iThinkiKhan/Universal-Robotics-Remote/exports/README.md

# Derived exports

Generated STEP models, drawings and review images belong here, with source revision and validation evidence. Native designs remain under cad/ and electronics/. Toolchain smoke exports are synthetic fixtures, not controller models or print deliveries. No automatic slicing or printer upload occurs.
