iThinkiKhan/Universal-Robotics-Remote/reference/README.md

# Reference material

Store upstream manuals, datasheets and externally supplied geometry with source URL, revision and license/provenance. Hardware photographs currently live in measurements/photos/. Do not promote a reference dimension to a measured assembly fact without evidence.
