iThinkiKhan/Universal-Robotics-Remote/THIRD_PARTY.md

# Third-party provenance

The synthetic ECAD/MCAD fixture incorporates the KiCad Packages3D model `Connector_PinHeader_2.54mm.3dshapes/PinHeader_1x04_P2.54mm_Vertical.step` in derived STEP and FreeCAD review files. Source: https://gitlab.com/kicad/libraries/kicad-packages3D . Original model SHA-256: `a74079b8d06bda78847623b39ee1855ffd1d9a8c1e896b349e4f1dc2056d44d9`. The upstream KiCad library is licensed under CC BY-SA 4.0 with its electronic-design exception; see https://www.kicad.org/libraries/license/ and the upstream model headers. These fixture files are synthetic validation geometry, not the measured gamepad.

Firmware library dependencies remain pinned in firmware/platformio.ini and retain their upstream licenses. Adapted pre-existing project drivers are identified in firmware/PROVENANCE.md. No new project-wide license is selected by this publication.
