iThinkiKhan/Universal-Robotics-Remote/docs/RECOVERY.md

# Private device recovery

Exact full-flash recovery was verified before bench firmware replacement. Recovery images can contain credentials, NVS and calibration and must remain private, outside this repository and its issues/artifacts. Keep identity, checksum and restore records in the owner's private lab records. Never erase flash, replace firmware, modify eFuses or change security settings merely to review the public project. A build does not authorize upload.
