iThinkiKhan/Universal-Robotics-Remote/docs/REFERENCES.md

# References and provenance

- Owner-provided hardware photographs and measurements, recorded2026-11-10. Exact private chat identifiers and device identities are excluded.
- Reused display/touch drivers: see `firmware/PROVENANCE.md`.
- KiCad: https://www.kicad.org/ and https://docs.kicad.org/10.0/en/cli/cli.html
- FreeCAD StepUp: https://github.com/easyw/kicadStepUpMod
- WireViz: https://github.com/wireviz/WireViz
- KiCad reference geometry: see `THIRD_PARTY.md`.
