iThinkiKhan/Universal-Robotics-Remote/electronics/harness-sources-proposed.csv

harness | pin | signal | function | source_pads | pad_label | x_mm | y_mm | pad_confidence | status | gate | s3_destination | notes
J1L | 1 | L-X | Left stick X (analog) | TP31 | L-X | 108.30 | 13.40 | high | plan-ready | LX-01 G1-G3 | GPIO5 (ADC1), proposed in the registry | Free round test pad, 1.3 mm. Owner-reported 0 to 3 V with the centre near 1.5 V. Electrical connection stays gated by the LX-01 steps and a qualified protective interface. Label read from photos 3086 and 3089 on 2026-11-11; this replaces the earlier blocked row.
J1L | 2 | L-Y | Left stick Y (analog) | TP32 | L-Y | 111.10 | 13.40 | high | plan-ready | LX-01 G1-G3 | GPIO6 (ADC1), proposed in the registry | Free round test pad, 1.3 mm. Owner-reported 0 to 3 V with the centre near 1.5 V. Electrical connection stays gated by the LX-01 steps and a qualified protective interface. Label read from photos 3086 and 3089 on 2026-11-11.
J1L | 3 | L-3 | Left stick click | TP30 | L-3 | 105.60 | 13.40 | high | plan-ready | LX-01 G1-G3 | GPIO not assigned in the registry yet | Free round test pad. Active-low: about 3 V released, 0 V pressed (owner-reported 2026-11-10, electrical.csv BTN05 and BTN06). Label read from photos 3086 and 3089 on 2026-11-11.
J1L | 4 | GND (J1L) | Signal reference for J1L | TP03 | VSS | 92.45 | 34.15 | high | plan-ready |  | S3 GND | Large VSS pad (2.8 mm) beside the left-hand pads. Owner-reported 2026-11-11: VSS is ground, checked against the large GND pad TP01 (electrical.csv GND01). Shared with the other left-hand connectors' ground returns: four wires on this pad.
J1R | 1 | R-X | Right stick X (analog) | TP11 | R-X | 27.85 | 10.75 | high | plan-ready | LX-01 G1-G3 | GPIO7 (ADC1), proposed in the registry | Free round test pad, 1.2 mm. Owner-reported 0 to 3 V with the centre near 1.5 V. Electrical connection stays gated by the LX-01 steps and a qualified protective interface.
J1R | 2 | R-Y | Right stick Y (analog) | TP10 | R-Y | 27.85 | 13.55 | high | plan-ready | LX-01 G1-G3 | GPIO2 (ADC1), proposed in the registry | Free round test pad, 1.2 mm. Owner-reported 0 to 3 V with the centre near 1.5 V. Electrical connection stays gated by the LX-01 steps and a qualified protective interface.
J1R | 3 | R-3 | Right stick click | TP12 | R-3 | 24.85 | 9.85 | high | plan-ready | LX-01 G1-G3 | GPIO not assigned in the registry yet | Labelled round test pad, high confidence. Active-low: about 3 V released, 0 V pressed (owner-reported 2026-11-10, electrical.csv BTN07 and BTN08).
J1R | 4 | GND (J1R) | Signal reference for J1R | TP01 | GND | 6.25 | 18.25 | high | plan-ready |  | S3 GND | Large GND pad (3 mm) near the battery end. Owner-reported 2026-11-11: checked against the VSS pad TP03, same net (electrical.csv GND01). Shared with the other right-hand connectors' ground returns: three wires on this pad.
J2F | 1 | R-UP | Face button X (top) | TP19 | R-UP | 40.45 | 23.95 | high | plan-ready | M4 | WROOM-32U input, GPIO not assigned (button processor adopted 2026-11-11) | Free round test pad, 1.2 mm, not a ribbon joint. Function is inferred from the printed label and the front-side layout; confirm with the button check sheet (M4) before soldering.
J2F | 2 | R-RIGHT | Face button A (right) | TP20 | R-RIGHT | 40.25 | 17.75 | high | plan-ready | M4 | WROOM-32U input, GPIO not assigned (button processor adopted 2026-11-11) | Free round test pad, 1.2 mm, not a ribbon joint. Function is inferred from the printed label and the front-side layout; confirm with the button check sheet (M4) before soldering.
J2F | 3 | R-DOWN | Face button B (bottom) | TP22 | R-DOWN | 43.85 | 10.95 | high | plan-ready | M4 | WROOM-32U input, GPIO not assigned (button processor adopted 2026-11-11) | Free round test pad, 1.2 mm, not a ribbon joint. Function is inferred from the printed label and the front-side layout; confirm with the button check sheet (M4) before soldering.
J2F | 4 | R-LEFT | Face button Y (left) | TP21 | R-LEFT | 43.85 | 14.75 | high | plan-ready | M4 | WROOM-32U input, GPIO not assigned (button processor adopted 2026-11-11) | Free round test pad, 1.2 mm, not a ribbon joint. One unnamed face button was measured active-low (owner-reported). Function is inferred from the printed label and the front-side layout; confirm with the button check sheet (M4) before soldering.
J2F | 5 | GND (J2F) | Signal reference for J2F | TP01 | GND | 6.25 | 18.25 | high | plan-ready |  | button processor GND | Large GND pad (3 mm) near the battery end. Owner-reported 2026-11-11: checked against the VSS pad TP03, same net (electrical.csv GND01). Shared with the other right-hand connectors' ground returns: three wires on this pad.
J2R | 1 | R-1 | Right shoulder R | TP58 | R-1 | 41.65 | 38.65 | high | plan-ready | M4 | WROOM-32U input, GPIO not assigned (button processor adopted 2026-11-11) | Free round test pad, 1.2 mm, not a ribbon joint. Using this pad avoids the SW2 ribbon joints. Function is inferred from the printed label and the front-side layout; confirm with the button check sheet (M4) before soldering.
J2R | 2 | R-2 | Right trigger ZR | TP59 | R-2 | 39.65 | 37.75 | high | plan-ready | M4 | WROOM-32U input, GPIO not assigned (button processor adopted 2026-11-11) | Free round test pad, 1.2 mm, not a ribbon joint. Using this pad avoids the SW2 ribbon joints. Function is inferred from the printed label and the front-side layout; confirm with the button check sheet (M4) before soldering.
J2R | 3 | GND (J2R) | Signal reference for J2R | TP01 | GND | 6.25 | 18.25 | high | plan-ready |  | button processor GND | Large GND pad (3 mm) near the battery end. Owner-reported 2026-11-11: checked against the VSS pad TP03, same net (electrical.csv GND01). Shared with the other right-hand connectors' ground returns: three wires on this pad.
J2D | 1 | L-UP | D-pad up | TP26 | L-UP | 97.00 | 16.00 | high | plan-ready | M4 | WROOM-32U input, GPIO not assigned (button processor adopted 2026-11-11) | Free round test pad, 1.3 mm, not a ribbon joint. Function is inferred from the printed label and the front-side layout; confirm with the button check sheet (M4) before soldering.
J2D | 2 | L-RIGHT | D-pad right | TP25 | L-RIGHT | 86.75 | 15.75 | high | plan-ready | M4 | WROOM-32U input, GPIO not assigned (button processor adopted 2026-11-11) | Free round test pad, 1.3 mm, not a ribbon joint. Function is inferred from the printed label and the front-side layout; confirm with the button check sheet (M4) before soldering.
J2D | 3 | L-DOWN | D-pad down | TP27 | L-DOWN | 91.15 | 10.15 | high | plan-ready | M4 | WROOM-32U input, GPIO not assigned (button processor adopted 2026-11-11) | Free round test pad, 1.3 mm, not a ribbon joint. Function is inferred from the printed label and the front-side layout; confirm with the button check sheet (M4) before soldering.
J2D | 4 | L-LEFT | D-pad left | TP24 | L-LEFT | 103.15 | 15.95 | high | plan-ready | M4 | WROOM-32U input, GPIO not assigned (button processor adopted 2026-11-11) | Free round test pad, 1.3 mm, not a ribbon joint. Function is inferred from the printed label and the front-side layout; confirm with the button check sheet (M4) before soldering.
J2D | 5 | GND (J2D) | Signal reference for J2D | TP03 | VSS | 92.45 | 34.15 | high | plan-ready |  | button processor GND | Large VSS pad (2.8 mm) beside the left-hand pads. Owner-reported 2026-11-11: VSS is ground, checked against the large GND pad TP01 (electrical.csv GND01). Shared with the other left-hand connectors' ground returns: four wires on this pad.
J2L | 1 | L-1 | Left shoulder L | TP72 | L-1 | 89.95 | 32.25 | high | plan-ready | M4 | WROOM-32U input, GPIO not assigned (button processor adopted 2026-11-11) | Free round test pad, 1.2 mm, not a ribbon joint. Using this pad avoids the SW1 ribbon joints. Function is inferred from the printed label and the front-side layout; confirm with the button check sheet (M4) before soldering.
J2L | 2 | L-2 | Left trigger ZL | TP71 | L-2 | 88.35 | 35.85 | high | plan-ready |  | WROOM-32U input, GPIO not assigned (button processor adopted 2026-11-11) | Free round test pad, not a ribbon joint. Active-low: about 3 V released, 0 V with the left shoulder held (owner-reported 2026-11-10, electrical.csv BTN10 and BTN11). The owner named the pad L-2, which is this pad's spelling (the ribbon pad is printed L2). Which of the two left shoulder switches was held is not recorded.
J2L | 3 | GND (J2L) | Signal reference for J2L | TP03 | VSS | 92.45 | 34.15 | high | plan-ready |  | button processor GND | Large VSS pad (2.8 mm) beside the left-hand pads. Owner-reported 2026-11-11: VSS is ground, checked against the large GND pad TP01 (electrical.csv GND01). Shared with the other left-hand connectors' ground returns: four wires on this pad.
J2C | 1 | K-+ | Plus / Start | TP73 | K-+ | 76.20 | 23.10 | high | plan-ready | M4 | WROOM-32U input, GPIO not assigned (button processor adopted 2026-11-11) | Free round test pad, 1.2 mm, not a ribbon joint. Function is inferred from the printed label and the front-side layout; confirm with the button check sheet (M4) before soldering.
J2C | 2 | K-- | Minus / Select | TP69|TP70 | K-- | 86.55 | 36.45 | low | blocked | M4 | WROOM-32U input, GPIO not assigned (button processor adopted 2026-11-11) | Two round pads sit either side of the printed K-- and the photo does not settle which one it names. One continuity check from the Minus button contact picks the pad.
J2C | 3 | H | HOME | TP68 | H | 83.05 | 35.95 | high | plan-ready | M4 | WROOM-32U input, GPIO not assigned (button processor adopted 2026-11-11) | Free round test pad, 1.2 mm, not a ribbon joint. The original controller may treat HOME as a wake key; check its released voltage in each power state. Function is inferred from the printed label and the front-side layout; confirm with the button check sheet (M4) before soldering.
J2C | 4 | GND (J2C) | Signal reference for J2C | TP03 | VSS | 92.45 | 34.15 | high | plan-ready |  | button processor GND | Large VSS pad (2.8 mm) beside the left-hand pads. Owner-reported 2026-11-11: VSS is ground, checked against the large GND pad TP01 (electrical.csv GND01). Shared with the other left-hand connectors' ground returns: four wires on this pad.
J2C | 5 | K_POW | POWER key of the original controller (the 16th button) | TP61 | K_POW | 70.90 | 17.90 | medium | hold | M8 | WROOM-32U input only after M8; never a 3.3 V input before it | Reserved position, not wired. K_POW may sit at battery voltage, which is unmeasured (M8); nothing connects to a 3.3 V input until the DC level with the gamepad off, on and asleep is recorded.
J3 |  | Gamepad power |  | TP02|TP01|TP07|TP48|TP51 | B+ | 16.65 | 18.25 | high | hold | G2; power-state qualification |  | No gamepad power harness is planned until the power circuit is decided and measured (D6). Never join the gamepad VCC, B+ or +5V to S3 3V3 or USB power. Pads listed are where power exists, not a plan to connect them.
NONE |  | SDA / SCL |  | TP05|TP06 | SDA | 92.00 | 22.25 | high | hold |  |  | Do not connect. A capture showed no activity and the bus is not established.
NONE |  | SYNCO, RSTN, RES, POW_DET, P_EN | Original controller sync, reset and power-management points | TP75|TP57|TP55|TP78|TP64 | SYNCO | 74.35 | 32.55 | medium | hold | M8 |  | Do not connect yet. They belong to the original controller's own sync, reset and power management and their direction and voltage are unmeasured (M8). The owner has not decided what sync and reset should do; the original controller's ICs keep running behind the scenes, so these pads may matter more than passive taps. POWER (K_POW, TP61) is listed on J2C pin 5.
RETAINED-R1 |  | Right-stick ribbon |  | TP14|TP15|TP16|TP17|TP18 | R-Y | 15.65 | 4.65 | medium | retained |  |  | Five-wire ribbon, R-Y VCC R-X GND R-3, soldered to pads at about 2.0 mm pitch. The original assembly stays intact; this row records where it lands.
RETAINED-R2 |  | Left-stick ribbon |  | TP33|TP34|TP35|TP36|TP37 | L-Y | 114.00 | 16.50 | medium | retained |  |  | Five-wire ribbon, L-Y VCC L-X GND L-3, soldered to pads at about 2.05 mm pitch. The original assembly stays intact; this row records where it lands.
RETAINED-R3 |  | Left shoulder ribbon |  | TP42|TP43|TP44|TP45 | GND | 89.40 | 38.90 | medium | retained |  |  | Four-wire ribbon, GND L2 L1 GND, to the left shoulder board. The original assembly stays intact; this row records where it lands.
RETAINED-R4 |  | Right shoulder ribbon |  | TP38|TP39|TP40|TP41 | GND | 37.60 | 42.25 | medium | retained |  |  | Four-wire ribbon, GND R2 R1 GND, to the right shoulder board. The original assembly stays intact; this row records where it lands.
RETAINED-R5 |  | Battery lead |  | TP48|TP49|TP50|TP51 | B- | 3.50 | 7.40 | medium | retained |  |  | Original battery connector footprint (four stripe pads). Pack pin count and third-wire function unverified. The original assembly stays intact; this row records where it lands.
RETAINED-R6 |  | Motor leads |  | TP46|TP47 | MO | 112.10 | 11.60 | medium | retained |  |  | Two rect pads beside the printed MO. The original assembly stays intact; this row records where it lands.
