iThinkiKhan/Universal-Robotics-Remote/electronics/netlist-proposed.csv

wire_id | connector | position | signal | gamepad_pad | far_board | far_pin | status | gate
J1L-W01 | J1L | 1 | L-X | TP31 | ESP32-S3 | GPIO5 | plan-ready | LX-01 G1-G3
J1L-W02 | J1L | 2 | L-Y | TP32 | ESP32-S3 | GPIO6 | plan-ready | LX-01 G1-G3
J1L-W03 | J1L | 3 | L-3 | TP30 | ESP32-S3 | GPIO21 | plan-ready | LX-01 G1-G3
J1L-W04 | J1L | 4 | GND | TP03 | ESP32-S3 | GND | plan-ready
J1R-W01 | J1R | 1 | R-X | TP11 | ESP32-S3 | GPIO7 | plan-ready | LX-01 G1-G3
J1R-W02 | J1R | 2 | R-Y | TP10 | ESP32-S3 | GPIO2 | plan-ready | LX-01 G1-G3
J1R-W03 | J1R | 3 | R-3 | TP12 | ESP32-S3 | GPIO1 | plan-ready | LX-01 G1-G3
J1R-W04 | J1R | 4 | GND | TP01 | ESP32-S3 | GND | plan-ready
J2F-W01 | J2F | 1 | R-UP | TP19 | DevKitC V4 (WROOM-32U) | GPIO36 | plan-ready | M4
J2F-W02 | J2F | 2 | R-RIGHT | TP20 | DevKitC V4 (WROOM-32U) | GPIO39 | plan-ready | M4
J2F-W03 | J2F | 3 | R-DOWN | TP22 | DevKitC V4 (WROOM-32U) | GPIO34 | plan-ready | M4
J2F-W04 | J2F | 4 | R-LEFT | TP21 | DevKitC V4 (WROOM-32U) | GPIO35 | plan-ready | M4
J2F-W05 | J2F | 5 | GND | TP01 | DevKitC V4 (WROOM-32U) | GND | plan-ready
J2R-W01 | J2R | 1 | R-1 | TP58 | DevKitC V4 (WROOM-32U) | GPIO23 | plan-ready | M4
J2R-W02 | J2R | 2 | R-2 | TP59 | DevKitC V4 (WROOM-32U) | GPIO22 | plan-ready | M4
J2R-W03 | J2R | 3 | GND | TP01 | DevKitC V4 (WROOM-32U) | GND | plan-ready
J2D-W01 | J2D | 1 | L-UP | TP26 | DevKitC V4 (WROOM-32U) | GPIO25 | plan-ready | M4
J2D-W02 | J2D | 2 | L-RIGHT | TP25 | DevKitC V4 (WROOM-32U) | GPIO26 | plan-ready | M4
J2D-W03 | J2D | 3 | L-DOWN | TP27 | DevKitC V4 (WROOM-32U) | GPIO27 | plan-ready | M4
J2D-W04 | J2D | 4 | L-LEFT | TP24 | DevKitC V4 (WROOM-32U) | GPIO13 | plan-ready | M4
J2D-W05 | J2D | 5 | GND | TP03 | DevKitC V4 (WROOM-32U) | GND | plan-ready
J2L-W01 | J2L | 1 | L-1 | TP72 | DevKitC V4 (WROOM-32U) | GPIO32 | plan-ready | M4
J2L-W02 | J2L | 2 | L-2 | TP71 | DevKitC V4 (WROOM-32U) | GPIO33 | plan-ready
J2L-W03 | J2L | 3 | GND | TP03 | DevKitC V4 (WROOM-32U) | GND | plan-ready
J2C-W01 | J2C | 1 | K-+ | TP73 | DevKitC V4 (WROOM-32U) | GPIO21 | plan-ready | M4
J2C-W02 | J2C | 2 | K-- | TP69|TP70 | DevKitC V4 (WROOM-32U) | GPIO19 | blocked | M4
J2C-W03 | J2C | 3 | H | TP68 | DevKitC V4 (WROOM-32U) | GPIO18 | plan-ready | M4
J2C-W04 | J2C | 4 | GND | TP03 | DevKitC V4 (WROOM-32U) | GND | plan-ready
J2C-W05 | J2C | 5 | K_POW | TP61 | DevKitC V4 (WROOM-32U) | GPIO4 (reserved, not wired) | hold | M8
