iThinkiKhan/Universal-Robotics-Remote/electronics/bench/lx-observer-proposed.png

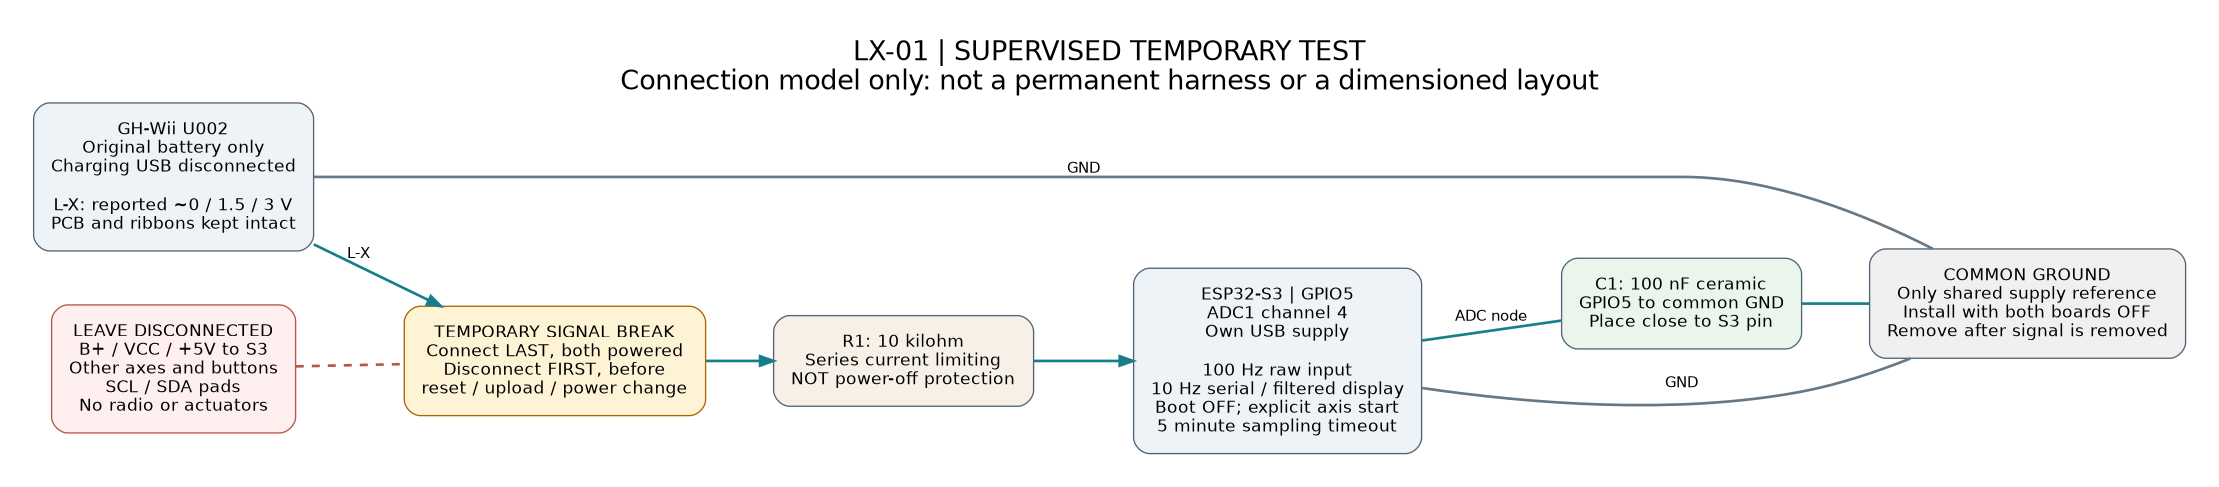
electronics/bench/lx-observer-proposed.png
