iThinkiKhan/Universal-Robotics-Remote/electronics/generated/j1l-proposed.png

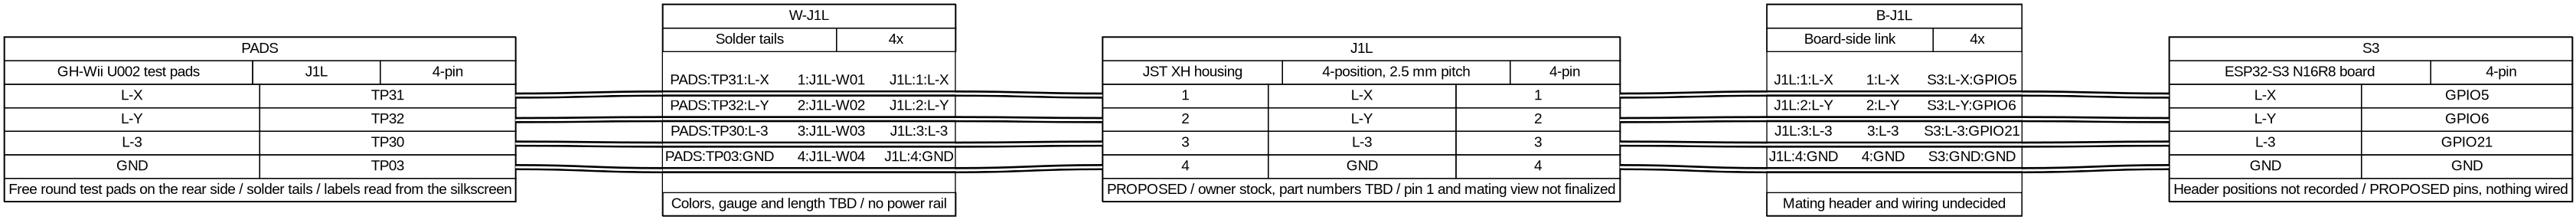
electronics/generated/j1l-proposed.png
