iThinkiKhan/Universal-Robotics-Remote/electronics/generated/j2c-proposed.png

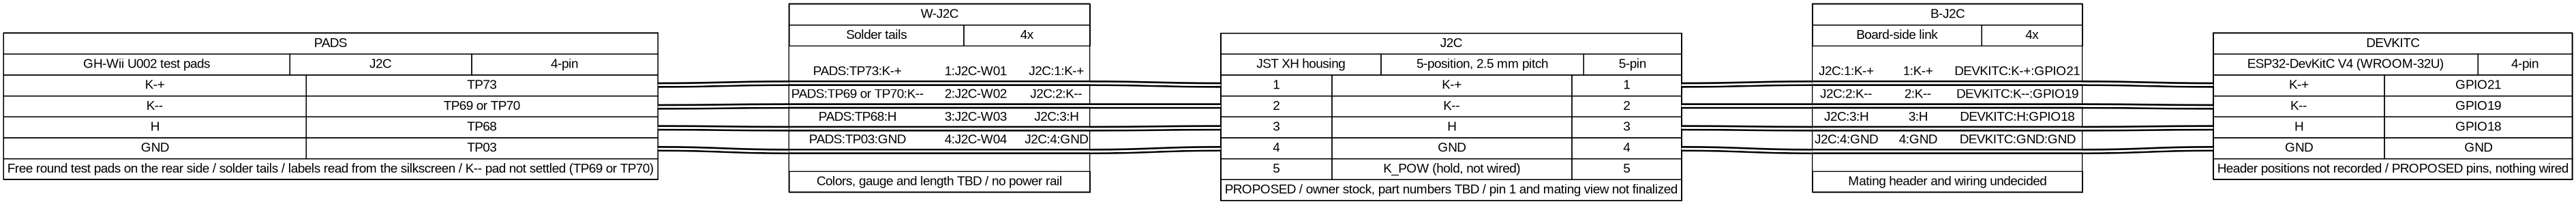
electronics/generated/j2c-proposed.png
