iThinkiKhan/Universal-Robotics-Remote/electronics/generated/j2d-proposed.png

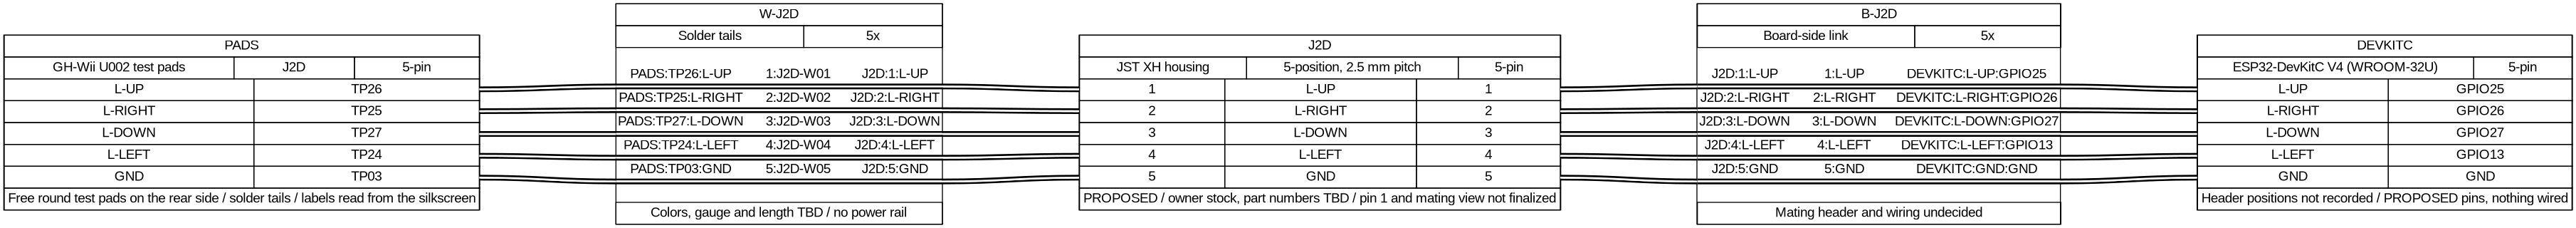
electronics/generated/j2d-proposed.png
