iThinkiKhan/Universal-Robotics-Remote/electronics/generated/j2l-proposed.png

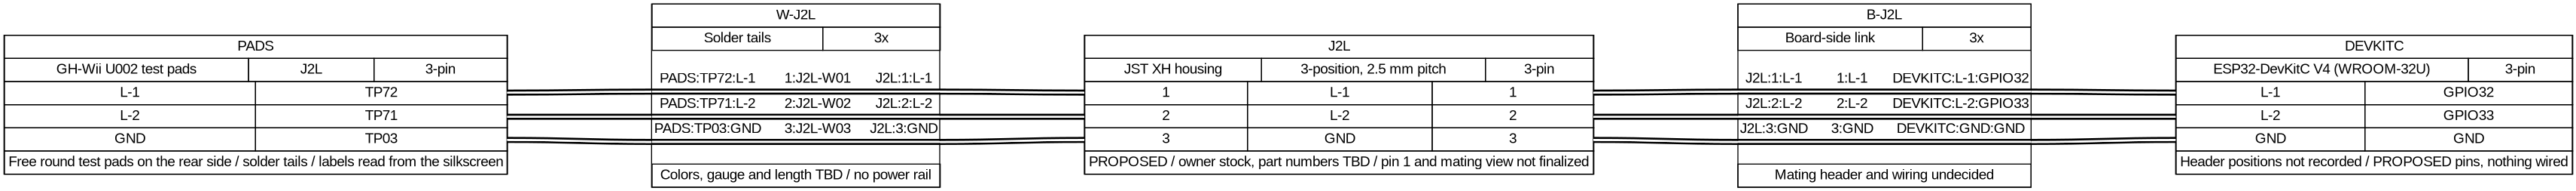
electronics/generated/j2l-proposed.png
