iThinkiKhan/Universal-Robotics-Remote/electronics/generated/overview-proposed.png

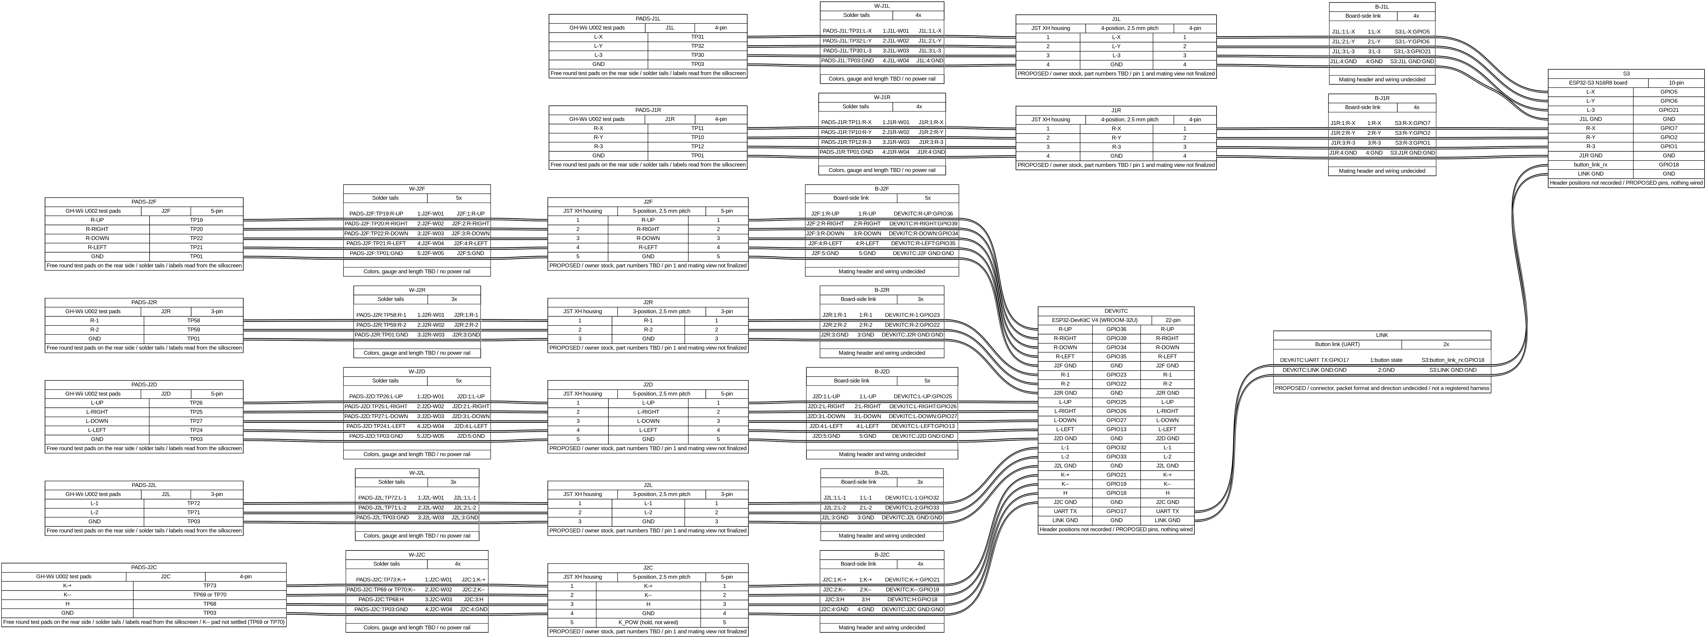
electronics/generated/overview-proposed.png
