iThinkiKhan/Universal-Robotics-Remote/exports/boards/gamepad-gh-wii-u002/gamepad-gh-wii-u002-outline-trace-check-REAR.png

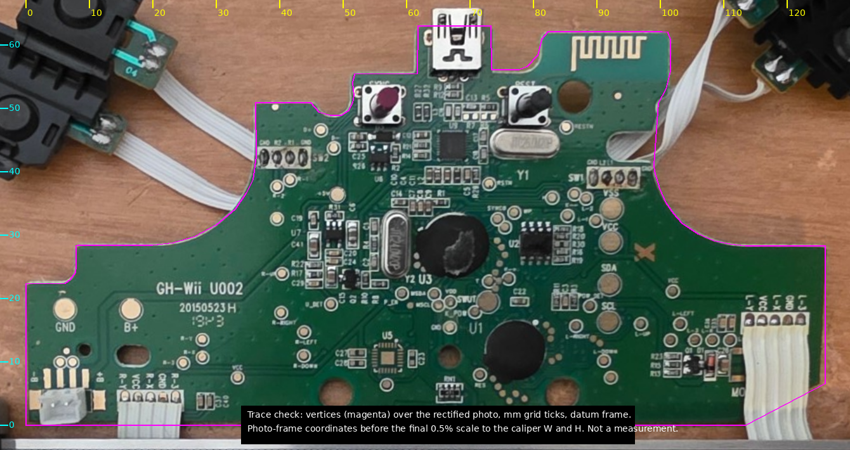
exports/boards/gamepad-gh-wii-u002/gamepad-gh-wii-u002-outline-trace-check-REAR.png
