iThinkiKhan/Universal-Robotics-Remote/exports/boards/gamepad-gh-wii-u002/gamepad-gh-wii-u002-pad-map-REAR.png

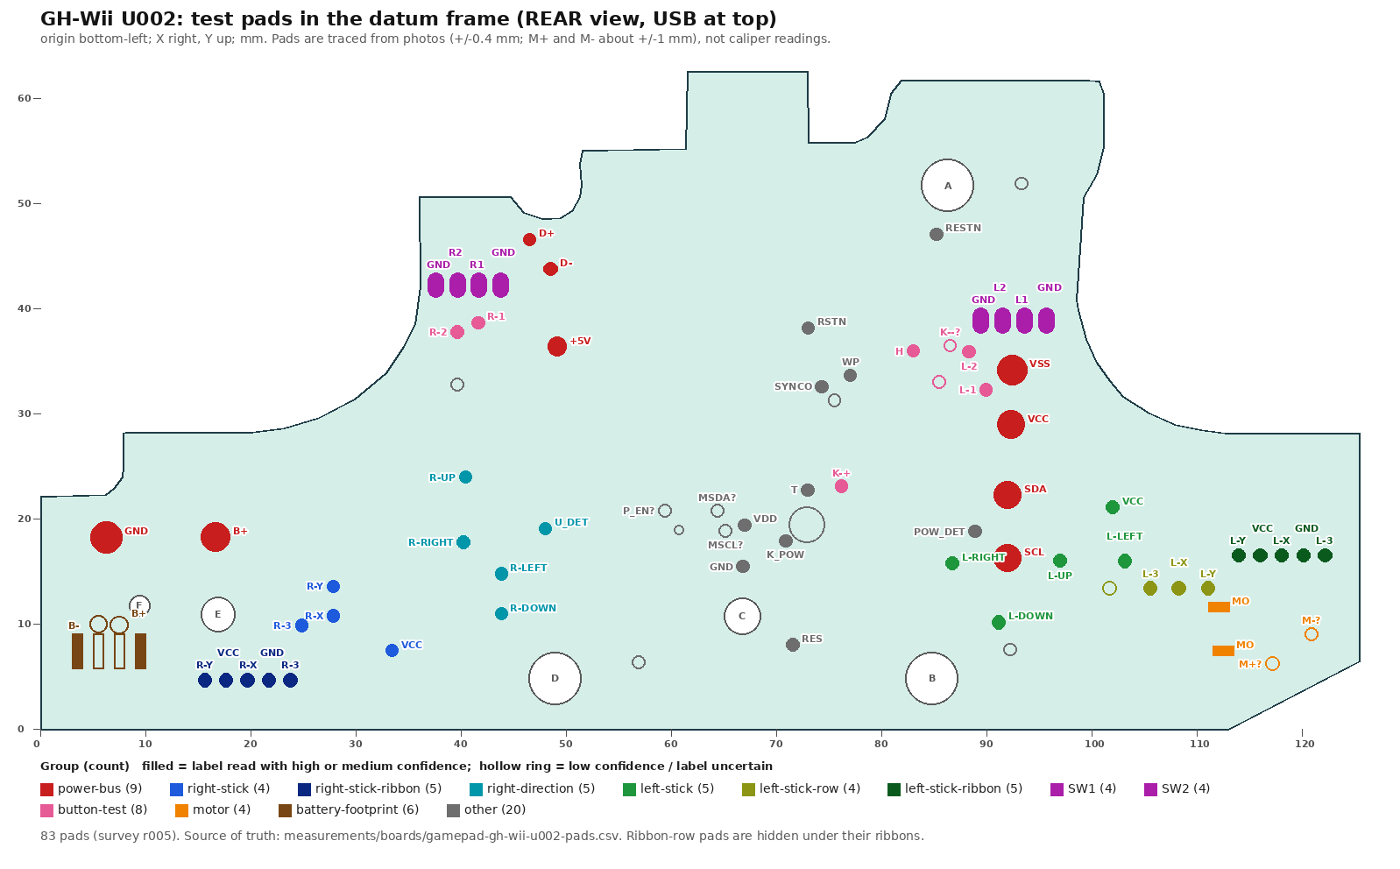
exports/boards/gamepad-gh-wii-u002/gamepad-gh-wii-u002-pad-map-REAR.png
