iThinkiKhan/Universal-Robotics-Remote/exports/boards/gamepad-gh-wii-u002/gamepad-gh-wii-u002-survey-r002-ENVELOPE_ONLY.png

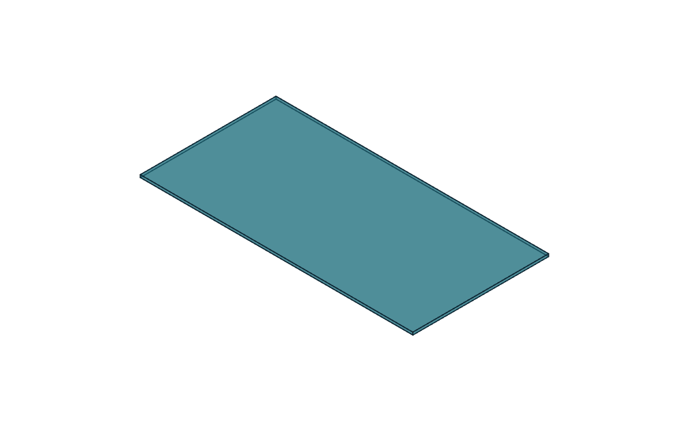
exports/boards/gamepad-gh-wii-u002/gamepad-gh-wii-u002-survey-r002-ENVELOPE_ONLY.png
