iThinkiKhan/Universal-Robotics-Remote/exports/boards/gamepad-gh-wii-u002/gamepad-gh-wii-u002-survey-r003-TRACED_OUTLINE.png

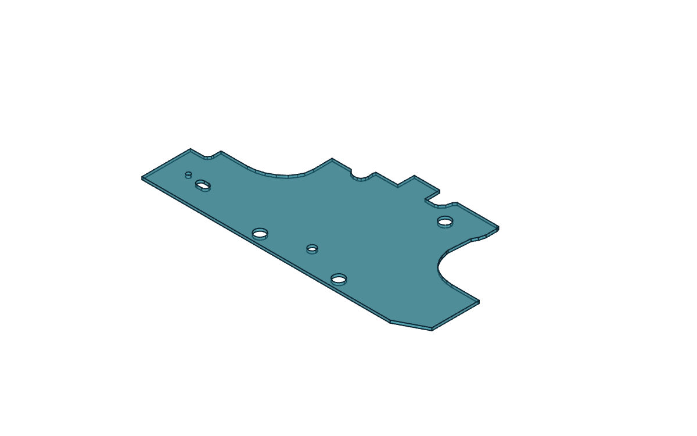
exports/boards/gamepad-gh-wii-u002/gamepad-gh-wii-u002-survey-r003-TRACED_OUTLINE.png
