iThinkiKhan/Universal-Robotics-Remote/exports/boards/gamepad-gh-wii-u002/gamepad-gh-wii-u002-survey-r004-TRACED_OUTLINE-TOP.png

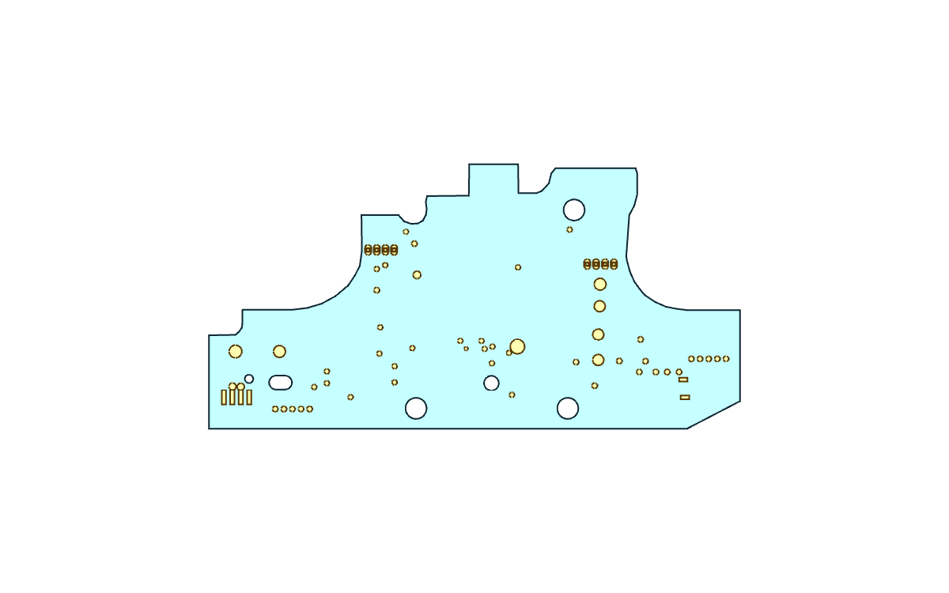
exports/boards/gamepad-gh-wii-u002/gamepad-gh-wii-u002-survey-r004-TRACED_OUTLINE-TOP.png
