iThinkiKhan/Universal-Robotics-Remote/exports/toolchain-smoke/SYNTHETIC_TOOLCHAIN_REVIEW.png

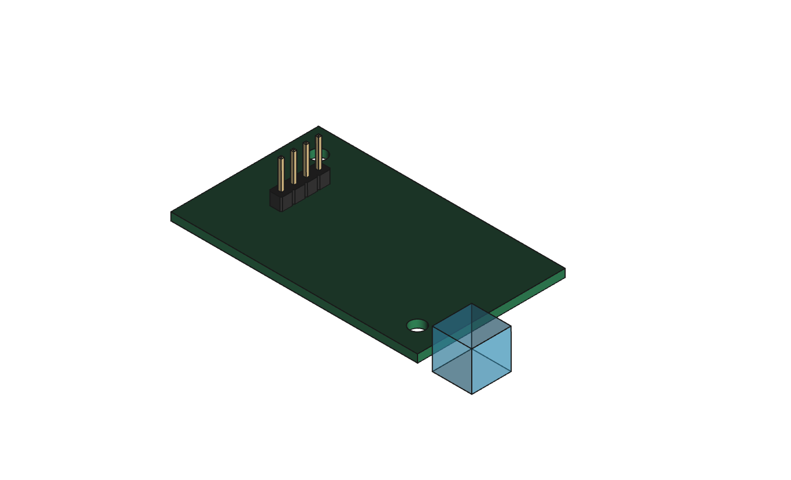
exports/toolchain-smoke/SYNTHETIC_TOOLCHAIN_REVIEW.png
