iThinkiKhan/Universal-Robotics-Remote/electronics/harness-procurement-proposed.csv

line | category | item | specification | candidate_part | qty | status | decision_or_reason | needed_for | verify_before_ordering
B01 | wire | Hook-up wire, 30 AWG, multi-colour | Stranded tinned copper, silicone insulation, about 0.8 mm outer diameter, at least six colours | any 30 AWG silicone kit or spool (for example Adafruit 30 AWG silicone spools) | 1 kit, at least 6 colours x 10 m | buy-now | Safe whatever connector is chosen; the thin flexible silicone insulation suits 1.2 mm pads and tight routing | tapping test pads; first prototype harness; bench leads | Confirm AWG, strand count and insulation diameter on the listing; kit lengths vary widely between sellers
B02 | solder | Fine solder, flux and braid | 0.5 mm solder, no-clean flux gel or pen, 1.5 mm desoldering braid, fine conical tip (0.2 to 0.4 mm) if not owned | generic | 1 set | buy-now | Pads are 1.2 mm with 2 mm pitch rows; low heat and a fine tip protect the original board | tapping pads | none
B03 | sleeving | Heat-shrink assortment | 1, 1.5, 2 and 3 mm, 2:1; plus adhesive-lined 3:1 for strain relief | generic | 1 assortment + 1 adhesive-lined pack | buy-now | Insulation of joints and strain relief at the solder end | every tap | none
B04 | insulation | Polyimide (Kapton) tape | 5 to 10 mm wide | generic | 1 roll | buy-now | Mask neighbouring pads and components while soldering; insulate bare joints | tapping pads | none
B05 | bench | Resistors for the LX-01 interface | 10 kOhm, 1 percent, 0.25 W metal film (through-hole) | generic | 20 | buy-now | The LX-01 plan calls for 10 kOhm per axis; spares for the other axes and for the S3-only reference test | LX-01 G1-G3 | none
B06 | bench | Ceramic capacitors for the LX-01 interface | 100 nF, X7R, 16 V or more (through-hole) | generic | 20 | buy-now | The LX-01 plan calls for 100 nF at the S3 end of each axis | LX-01 G1-G3 | none
B07 | bench | Micro test hooks or grabbers | SMD-style clip probes, 0.5 to 1 mm tip, with leads compatible with your meter | generic | 1 set of 6 to 10 | buy-now | Lets pads be probed during characterisation (M2, M4) without soldering to the original board | M2; M4; G2 | none
B08 | labels | Wire marker labels | Self-laminating wrap labels or printable heat-shrink markers, 6 to 10 mm | generic | 1 pack | buy-now | Issue 5 requires every wire to carry its ID; label as you build | all harnesses | none
B09 | connector eval | JST GH 8-position pre-crimped lead, evaluation lot | 8 positions, 1.25 mm pitch, GHR-08V-S housing with SSHL-002T-P0.2 contacts, about 28 AWG, 150 mm, single-ended if offered | GHR-08V-S with SSHL-002T-P0.2 (assembled) | 5 | buy-now | Evaluation only: judges size and latch feel against the real board. The family is not final until D1 | D1 | Confirm the assembled-cable part number, wire gauge and whether it is single- or double-ended; SSHL-003 contacts do NOT fit GH
B10 | connector eval | JST GH matching board-side header, evaluation lot | Side-entry SMT header, 8 circuits, 1.25 mm | SM08B-GHS-TB | 5 | buy-now | Mates with B09 for a bench check and for a first interface-board footprint study | D1; D2 | Confirm side-entry versus top-entry for the intended board layout
B11 | connector eval | Hirose DF13 8-position pre-crimped lead, alternative evaluation lot | 8 positions, 1.25 mm pitch, DF13-8S-1.25C housing with DF13-2630SCF contacts (26 to 30 AWG) | DF13-8S-1.25C with DF13-2630SCF | 3 | buy-now | Alternative family to compare latch and fit; cheap. Do not order more than the lot until D1 | D1 | A web search did not confirm a positive latch for DF13; check Hirose's datasheet before relying on retention
B12 | connector eval | Hirose DF13 board-side header, alternative evaluation lot | Right-angle SMT header, 8 positions | DF13A-8P-1.25H | 3 | buy-now | Mates with B11 | D1 | Confirm plating option and right-angle versus straight
A01 | connector | Final harness connectors, housings and contacts | JST XH housings and contacts (owner stock, 2 to 6 positions): 4 positions for J1L and J1R, 5 for J2F, J2D and J2C (a fifth on J2C is reserved for POWER), 3 for J2R and J2L, plus spares | JST XH series, part numbers TBD (check the owner stock) | per D1 | buy-after-decision | D1 (owner stock is JST XH; check the housing and contact part numbers) and D5 (where the ends sit); the interface at the S3 and WROOM ends is still open | J1L, J1R, J2F, J2R, J2D, J2L, J2C | after D1
A02 | tool | Crimp tool for the chosen contact | Manufacturer-recommended tool for the chosen family | per D1 | 1 | buy-after-decision | D1. A wrong tool damages small contacts; pre-crimped leads avoid the need for it | final harnesses | after D1
A03 | interface | Interface board design and parts | Per-channel series resistor and capacitor, protection for an unpowered or fault state, ground and connector footprints | designed in KiCad | per design | buy-after-decision | D2. Protection is added only if a need is shown (owner direction, 2026-11-11); LX-01 states the resistor-only circuit is not power-off safe, so this must be qualified before a permanent harness | permanent J1L and J1R | after D2 and design review
A04 | connector | S3-side connectors | Header sockets or direct board connectors for the S3 GPIOs actually used, and for the WROOM-32U DevKitC V4 inputs (2.54 mm headers, so 2.5 mm XH housings do not plug straight onto them: a carrier or perforated board with XH headers is one option) | per D2 | per D2 | buy-after-decision | D2 and the S3 location (D5) | J1L, J1R, J2F, J2R, J2D, J2L, J2C | after D2
A05 | sleeving | Cable sleeving and strain relief | Braided expandable sleeving 2 to 3 mm, cable clamps or anchors | generic | per length | buy-after-decision | D5 and the routed 3D lengths | all harnesses | after the routed assembly
A06 | wire | Cut-to-length wire and final lengths | Per routed length plus service loop | B01 stock | per cut list | buy-after-decision | Lengths come from the 3D routing, which needs the S3, display and battery positions (D5, M5) | all harnesses | after routing
A07 | connector | Shoulder-button tap hardware | Depends on D3 (piggyback on the ribbon pads, tap at the shoulder boards, or an inline connector) | per D3 | per D3 | buy-after-decision | D3 and M4 | J2R, J2L | after D3
H01 | power | Any gamepad power connector or harness (J3) | none | none | 0 | hold | Held until the power circuit is decided and measured (G2, D6). A keyed, physically distinct connector is designed only after that | J3 | not applicable
H02 | bus | Anything wired to SDA or SCL | none | none | 0 | hold | The bus is not established and no activity was captured; wiring it risks the original processor | none | not applicable
H03 | actuator | Actuator, ESC or radio connectors | none | none | 0 | hold | Out of scope until receiver failsafe, arming, link-loss and deadman behaviour are designed and tested | none | not applicable
