iThinkiKhan/Universal-Robotics-Remote/measurements/electrical.csv

id | component | quantity | condition | reference | value | unit | uncertainty | instrument | date | evidence | status
V01 | PAD1 | VCC | original battery only; gamepad active |  | 3.0 | V |  |  | 2026-11-12 | owner power handoff 2026-11-12 | owner-reported
V02 | PAD1 | VCC | original battery gamepad off USB disconnected | GND |  | V |  |  |  |  | pending
V03 | PAD1 | +5V | original battery only; gamepad active and idle |  | 0 | V |  |  | 2026-11-12 | owner power handoff 2026-11-12 | owner-reported
V04 | PAD1 | +5V | original battery and USB charging connected; after LED timeout | GND | 5.00 | V |  | digital multimeter model unknown | 2026-11-10 | owner bench report 2026-11-10 | owner-reported
V05 | BAT1 | original pack voltage | original 3.7 V LiPo; load state unspecified |  | 4.0 | V |  |  | 2026-11-12 | owner power handoff 2026-11-12 | owner-reported
V06 | PAD1 | VCC state | original battery only; after pairing LEDs stop |  | shuts off | qualitative |  |  | 2026-11-12 | owner power handoff 2026-11-12 | owner-reported
AX01 | PAD1 | L-X | battery-only and USB disconnected; minimum after LED pairing timeout | GND | 0 | V |  | digital multimeter model unknown | 2026-11-10 | owner bench report 2026-11-10 | owner-reported
AX02 | PAD1 | L-X | battery-only and USB disconnected; center after LED pairing timeout | GND | 1.5 | V |  | digital multimeter model unknown | 2026-11-10 | owner bench report 2026-11-10 | owner-reported
AX03 | PAD1 | L-X | battery-only and USB disconnected; maximum after LED pairing timeout | GND | 3.0 | V |  | digital multimeter model unknown | 2026-11-10 | owner bench report 2026-11-10 | owner-reported
AY01 | PAD1 | L-Y | battery-only and USB disconnected; minimum after LED pairing timeout | GND | 0 | V |  | digital multimeter model unknown | 2026-11-10 | owner bench report 2026-11-10 | owner-reported
AY02 | PAD1 | L-Y | battery-only and USB disconnected; center after LED pairing timeout | GND | 1.5 | V |  | digital multimeter model unknown | 2026-11-10 | owner bench report 2026-11-10 | owner-reported
AY03 | PAD1 | L-Y | battery-only and USB disconnected; maximum after LED pairing timeout | GND | 3.0 | V |  | digital multimeter model unknown | 2026-11-10 | owner bench report 2026-11-10 | owner-reported
RX01 | PAD1 | R-X | battery-only and USB disconnected; minimum after LED pairing timeout | GND | 0 | V |  | digital multimeter model unknown | 2026-11-10 | owner bench report 2026-11-10 | owner-reported
RX02 | PAD1 | R-X | battery-only and USB disconnected; center after LED pairing timeout | GND | 1.5 | V |  | digital multimeter model unknown | 2026-11-10 | owner bench report 2026-11-10 | owner-reported
RX03 | PAD1 | R-X | battery-only and USB disconnected; maximum after LED pairing timeout | GND | 3.0 | V |  | digital multimeter model unknown | 2026-11-10 | owner bench report 2026-11-10 | owner-reported
RY01 | PAD1 | R-Y | battery-only and USB disconnected; minimum after LED pairing timeout | GND | 0 | V |  | digital multimeter model unknown | 2026-11-10 | owner bench report 2026-11-10 | owner-reported
RY02 | PAD1 | R-Y | battery-only and USB disconnected; center after LED pairing timeout | GND | 1.5 | V |  | digital multimeter model unknown | 2026-11-10 | owner bench report 2026-11-10 | owner-reported
RY03 | PAD1 | R-Y | battery-only and USB disconnected; maximum after LED pairing timeout | GND | 3.0 | V |  | digital multimeter model unknown | 2026-11-10 | owner bench report 2026-11-10 | owner-reported
BTN01 | PAD1 | face button exact pad TBD | released | GND |  | V |  |  |  |  | pending
BTN02 | PAD1 | face button exact pad TBD | pressed | GND |  | V |  |  |  |  | pending
BTN03 | PAD1 | shoulder exact pad TBD | released | GND |  | V |  |  |  |  | pending
BTN04 | PAD1 | shoulder exact pad TBD | pressed | GND |  | V |  |  |  |  | pending
DIM04 | PAD1 | joystick center spacing | center to center |  |  | mm |  |  |  |  | pending
DIM05 | BAT1 | width | pack external envelope |  |  | mm |  |  |  |  | pending
DIM06 | BAT1 | height | pack external envelope |  |  | mm |  |  |  |  | pending
DIM07 | BAT1 | depth | pack external envelope |  |  | mm |  |  |  |  | pending
P01 | BAT1 | B+ | battery connected and charging via USB; after LED timeout | GND | 4.15 | V |  | digital multimeter model unknown | 2026-11-10 | owner bench report 2026-11-10 | owner-reported
P02 | PAD1 | VCC adjacent R stick | battery connected and USB charging; after LED timeout | GND | 2.99 | V |  | digital multimeter model unknown | 2026-11-10 | owner bench report 2026-11-10 | owner-reported
P03 | PAD1 | VCC adjacent L stick | battery connected and USB charging; after LED timeout | GND | 2.99 | V |  | digital multimeter model unknown | 2026-11-10 | owner bench report 2026-11-10 | owner-reported
P04 | PAD1 | VCC near left shoulder | battery connected and USB charging; after LED timeout | GND | 3.0 | V | approx | digital multimeter model unknown | 2026-11-10 | owner bench report 2026-11-10 | owner-reported
P05 | PAD1 | R-X | battery connected and USB charging; at center after LED timeout | GND | 1.47 | V |  | digital multimeter model unknown | 2026-11-10 | owner bench report 2026-11-10 | owner-reported
P06 | PAD1 | R-Y | battery connected and USB charging; at center after LED timeout | GND | 1.47 | V |  | digital multimeter model unknown | 2026-11-10 | owner bench report 2026-11-10 | owner-reported
P07 | PAD1 | VCC supply retention | pairing LEDs extinguished; 3V rail remains present; power combination not reconfirmed | GND | 3.0 | V | approx | digital multimeter model unknown | 2026-11-10 | owner bench report 2026-11-10 | owner-reported
BTN05 | PAD1 | L-3 | released after LED timeout; supply arrangement not explicitly stated | GND | 3.0 | V | approx | digital multimeter model unknown | 2026-11-10 | owner bench report 2026-11-10 | owner-reported
BTN06 | PAD1 | L-3 | pressed after LED timeout; supply arrangement not explicitly stated | GND | 0 | V | approx | digital multimeter model unknown | 2026-11-10 | owner bench report 2026-11-10 | owner-reported
BTN07 | PAD1 | R-3 | released after LED timeout; supply arrangement not explicitly stated | GND | 3.0 | V | approx | digital multimeter model unknown | 2026-11-10 | owner bench report 2026-11-10 | owner-reported
BTN08 | PAD1 | R-3 | pressed after LED timeout; supply arrangement not explicitly stated | GND | 0 | V | approx | digital multimeter model unknown | 2026-11-10 | owner bench report 2026-11-10 | owner-reported
BTN09 | PAD1 | sampled other buttons not individually identified | released; after LED timeout; power combination not reconfirmed | GND | 3.0 | V | approx | digital multimeter model unknown | 2026-11-10 | owner bench report 2026-11-10 | owner-reported; pressed state pending
BUS01 | PAD1 | SCL | idle after LED timeout; power combination not reconfirmed | GND | 3.0 | V | approx | digital multimeter model unknown | 2026-11-10 | owner bench report 2026-11-10 | owner-reported; bus not identified
BUS02 | PAD1 | SDA | idle after LED timeout; power combination not reconfirmed | GND | 3.0 | V | approx | digital multimeter model unknown | 2026-11-10 | owner bench report 2026-11-10 | owner-reported; bus not identified
BTN10 | PAD1 | L-2 (owner label) | released; gamepad powered; supply arrangement not re-confirmed | GND | 3.0 | V | approx | digital multimeter model unknown | 2026-11-10 | owner bench report 2026-11-10 | owner-reported
BTN11 | PAD1 | L-2 (owner label) | left shoulder held; gamepad powered; supply arrangement not re-confirmed | GND | 0 | V | approx | digital multimeter model unknown | 2026-11-10 | owner bench report 2026-11-10 | owner-reported
BTN12 | PAD1 | face button exact pad not identified | released; gamepad powered; supply arrangement not re-confirmed | GND | 3.0 | V | approx | digital multimeter model unknown | 2026-11-10 | owner bench report 2026-11-10 | owner-reported
BTN13 | PAD1 | face button exact pad not identified | pressed; gamepad powered; supply arrangement not re-confirmed | GND | 0 | V | approx | digital multimeter model unknown | 2026-11-10 | owner bench report 2026-11-10 | owner-reported
BUS03 | PAD1 | large SCL and SDA pads | DIY logic analyzer during startup and failed receiver pairing; no usable capture file supplied | GND | no communication observed | qualitative | unknown | DIY logic analyzer sample settings unknown | 2026-11-10 | owner bench report 2026-11-10 | owner-reported limited-window observation
GND01 | PAD1 | VSS large pad (TP03) to the large GND pad (TP01) | owner statement after checking the two pads against each other; method and supply state were not stated | large GND pad (TP01) | ground | qualitative |  |  | 2026-11-11 | owner statement 2026-11-11 | owner-reported
