iThinkiKhan/Universal-Robotics-Remote/measurements/templates/module-readings.csv

id | module | reading | tier | how_to_measure | unit | value | instrument | date | state | notes
S3-W | s3 | PCB width (X extent), side to side | 1 | Caliper across the PCB, not including header pins | mm |  |  |  | pending
S3-L | s3 | PCB length (Y extent), datum end to USB end | 1 | PCB only; ignore a USB shell that overhangs | mm |  |  |  | pending
S3-T | s3 | PCB thickness | 1 | Bare board edge, away from components | mm |  |  |  | pending
S3-TALL | s3 | Height of the tallest part above the PCB top | 1 | Probably a USB-C shell or the module can; say which in notes | mm |  |  |  | pending
S3-HDR-LX | s3 | Left header row: X of the pin centres | 1 | Datum edge to the middle of the pins in the left row | mm |  |  |  | pending
S3-HDR-RX | s3 | Right header row: X of the pin centres | 1 | Datum edge to the middle of the pins in the right row | mm |  |  |  | pending
S3-HDR-P | s3 | Pin pitch along the row | 1 | Measure 10 pins edge to edge of first and last pin, divide by 9; write the pitch | mm |  |  |  | pending
S3-HDR-N | s3 | Pins per row (a count, not mm) | 1 | Count; put the number in notes and leave value blank if you prefer | mm |  |  |  | pending
S3-HDR-Y1 | s3 | Y of the first pin centre in a row | 1 | Datum bottom edge to the pin nearest the datum end | mm |  |  |  | pending
S3-HDR-H | s3 | Header body height above the PCB top | 2 | Plastic housing only | mm |  |  |  | pending
S3-HDR-PIN | s3 | Pin length sticking out below the PCB | 2 | Zero if headers are not soldered on | mm |  |  |  | pending
S3-USB1-X | s3 | USB connector 1: datum edge to its near (left) side | 1 | Near-wall reading, like the gamepad holes | mm |  |  |  | pending
S3-USB1-W | s3 | USB connector 1: shell width | 1 |  | mm |  |  |  | pending
S3-USB1-H | s3 | USB connector 1: shell height above the PCB top | 2 |  | mm |  |  |  | pending
S3-USB1-OVR | s3 | USB connector 1: how far the shell sticks out past the PCB end (negative if inside) | 2 | Straight edge across the PCB end | mm |  |  |  | pending
S3-USB2-X | s3 | USB connector 2: datum edge to its near (left) side | 1 | Only if the board has two | mm |  |  |  | pending
S3-USB2-W | s3 | USB connector 2: shell width | 1 |  | mm |  |  |  | pending
S3-MOD-X | s3 | Radio module can: datum edge to its left side | 2 |  | mm |  |  |  | pending
S3-MOD-Y | s3 | Radio module can: datum bottom edge to its lower side | 2 |  | mm |  |  |  | pending
S3-MOD-W | s3 | Radio module can: width (X) | 2 | Include the antenna tongue as a separate note if it differs | mm |  |  |  | pending
S3-MOD-L | s3 | Radio module can: length (Y) | 2 |  | mm |  |  |  | pending
S3-MOD-H | s3 | Radio module can: height above the PCB top | 2 |  | mm |  |  |  | pending
S3-BTN-H | s3 | Boot and reset buttons: height above the PCB top | 3 | Needed only if the enclosure must reach them | mm |  |  |  | pending
D-W | display | PCB width (X extent) | 1 |  | mm |  |  |  | pending
D-L | display | PCB length (Y extent) | 1 | Header edge to the far edge | mm |  |  |  | pending
D-T | display | PCB thickness | 1 |  | mm |  |  |  | pending
D-PANEL-T | display | Glass and touch layer: thickness above the PCB front surface | 1 | Measure from the PCB front to the touch-glass top | mm |  |  |  | pending
D-PANEL-X | display | Glass: datum edge to its left side | 1 |  | mm |  |  |  | pending
D-PANEL-Y | display | Glass: datum bottom edge to its lower side | 1 |  | mm |  |  |  | pending
D-PANEL-W | display | Glass: width (X) | 1 |  | mm |  |  |  | pending
D-PANEL-L | display | Glass: length (Y) | 1 |  | mm |  |  |  | pending
D-VIEW-X | display | Visible screen window: datum edge to its left side | 1 | The lit area, not the black border | mm |  |  |  | pending
D-VIEW-Y | display | Visible screen window: datum bottom edge to its lower side | 1 |  | mm |  |  |  | pending
D-VIEW-W | display | Visible screen window: width (X) | 1 |  | mm |  |  |  | pending
D-VIEW-L | display | Visible screen window: length (Y) | 1 |  | mm |  |  |  | pending
D-REAR-H | display | Tallest rear part: height above the PCB rear surface | 1 | Pin header body, SD slot or chip; say which in notes | mm |  |  |  | pending
D-HDR-X1 | display | Header: X of the first pin centre | 2 | Pin nearest the left datum edge | mm |  |  |  | pending
D-HDR-Y | display | Header: Y of the pin centres | 2 | Datum bottom edge to the middle of the pin row | mm |  |  |  | pending
D-HDR-P | display | Header pin pitch | 2 | Measure several pins and divide | mm |  |  |  | pending
D-HDR-N | display | Header pin count (a count, not mm) | 2 | Count; put in notes | mm |  |  |  | pending
D-HDR-H | display | Header body height above the PCB rear surface | 2 |  | mm |  |  |  | pending
D-HDR-PIN | display | Header pin length sticking out | 2 | Zero if no header is soldered | mm |  |  |  | pending
D-SD-X | display | microSD slot: datum edge to its left side | 3 | Skip if there is no slot | mm |  |  |  | pending
D-SD-Y | display | microSD slot: datum bottom edge to its lower side | 3 |  | mm |  |  |  | pending
D-SD-W | display | microSD slot: width (X) | 3 |  | mm |  |  |  | pending
D-SD-L | display | microSD slot: length (Y) | 3 |  | mm |  |  |  | pending
D-HA-XNEAR | display | Mounting hole A: datum edge to the hole's near wall | 2 | Skip all hole rows if there are none | mm |  |  |  | pending
D-HA-YNEAR | display | Mounting hole A: datum edge to the hole's near wall | 2 |  | mm |  |  |  | pending
D-HA-D | display | Mounting hole A: diameter | 2 |  | mm |  |  |  | pending
D-HB-XNEAR | display | Mounting hole B: datum edge to the hole's near wall | 2 | Repeat for any further holes in notes | mm |  |  |  | pending
D-HB-YNEAR | display | Mounting hole B: datum edge to the hole's near wall | 2 |  | mm |  |  |  | pending
D-HB-D | display | Mounting hole B: diameter | 2 |  | mm |  |  |  | pending
M-W | mic | PCB width (X extent) | 1 |  | mm |  |  |  | pending
M-L | mic | PCB length (Y extent) | 1 |  | mm |  |  |  | pending
M-T | mic | PCB thickness | 1 |  | mm |  |  |  | pending
M-CHIP-H | mic | Microphone chip: height above the PCB top | 1 |  | mm |  |  |  | pending
M-PORT-X | mic | Sound port hole: datum edge to its centre | 1 | The microphone is bottom-ported: the hole through the PCB under the chip | mm |  |  |  | pending
M-PORT-Y | mic | Sound port hole: datum edge to its centre | 1 |  | mm |  |  |  | pending
M-PORT-D | mic | Sound port hole diameter | 2 |  | mm |  |  |  | pending
M-HDR-X1 | mic | Header: X of the first pin centre | 2 | Pin nearest the left datum edge | mm |  |  |  | pending
M-HDR-Y | mic | Header: Y of the pin centres | 2 |  | mm |  |  |  | pending
M-HDR-P | mic | Header pin pitch | 2 |  | mm |  |  |  | pending
M-HDR-N | mic | Header pin count (a count, not mm) | 2 |  | mm |  |  |  | pending
M-HDR-H | mic | Header body height above the surface it sits on | 2 | Say which face the header is on in notes | mm |  |  |  | pending
M-HDR-PIN | mic | Header pin length sticking out | 2 | Zero if no header is soldered | mm |  |  |  | pending
M-HOLE-XNEAR | mic | Mounting hole: datum edge to the hole's near wall | 3 | Skip if there is no hole | mm |  |  |  | pending
M-HOLE-YNEAR | mic | Mounting hole: datum edge to the hole's near wall | 3 |  | mm |  |  |  | pending
M-HOLE-D | mic | Mounting hole diameter | 3 |  | mm |  |  |  | pending
