iThinkiKhan/Universal-Robotics-Remote/measurements/templates/pod-readings.csv

id | module | reading | tier | how_to_measure | unit | value | instrument | date | state | notes
POD-SITE | shell | Where the pod sits on the original shell | 1 | Words or a photo: top edge above the USB port, the back, or elsewhere | text |  |  |  | pending
SH-W | shell | Shell width across the chosen site | 1 | Caliper or rule across the flat or straightest part of the site | mm |  |  |  | pending
SH-T | shell | Shell thickness front to back at the chosen site | 1 | Caliper across both shell halves at the site | mm |  |  |  | pending
SH-GRIP | shell | Distance between the two grips at the site | 2 | Inside faces of the grips where a pod or bracket would pass | mm |  |  |  | pending
SH-USB | shell | USB opening centre from the left end of SH-W | 2 | Rear side up, as in the board datum view | mm |  |  |  | pending
SH-SCREW | shell | Shell screw positions near the site | 2 | A square-on photo with a rule in view is enough | photo |  |  |  | pending
SH-BATT | shell | Battery door or lead exit nearest the site | 2 | Where a two-wire power lead can leave the shell without cutting it; photo | photo |  |  |  | pending
WRM-H | devkitc | Overall height from pin tips to the tallest part | 1 | Caliper over the header pins and the module can | mm |  |  |  | pending
WRM-ANT | devkitc | External antenna size and lead length | 2 | Antenna body and the length of its lead | mm |  |  |  | pending
CHG-L | charger | Board length including the USB-C shell | 1 | Caliper end to end | mm |  |  |  | pending
CHG-W | charger | Board width | 1 |  | mm |  |  |  | pending
CHG-H | charger | Overall thickness including the USB-C shell | 1 |  | mm |  |  |  | pending
REG-L | regulator | Board length | 1 |  | mm |  |  |  | pending
REG-W | regulator | Board width | 1 |  | mm |  |  |  | pending
REG-H | regulator | Overall thickness including the tallest part | 1 |  | mm |  |  |  | pending
SW-BODY | switch | Switch body length, width and depth behind the panel | 1 | Three values in notes | mm |  |  |  | pending
SW-LEVER | switch | Lever width and total travel | 1 |  | mm |  |  |  | pending
DISP-DUP | display | Direction of the 28 mm Dupont allowance | 1 | Straight back from the screen face, or along the board past the header edge | text |  |  |  | pending
DISP-SCR | display | Screen edge to the non-header end of the PCB | 1 | Caliper from the PCB short edge to the start of the glass | mm |  |  |  | pending
DISP-SD | display | Which face the SD slot is on | 1 | Screen side or rear side | text |  |  |  | pending
BAT-LEAD | battery | Lead exit edge and lead length | 2 | Which 36 mm or 65 mm edge the wires leave from | mm |  |  |  | pending
