iThinkiKhan/Universal-Robotics-Remote/exports/toolchain-smoke/SYNTHETIC_STEPUP_ASSEMBLY.step

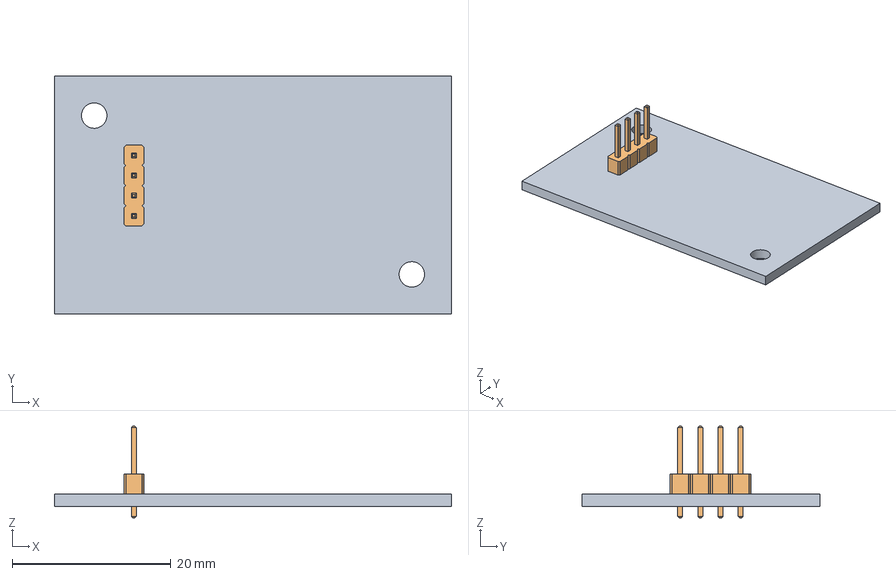
[picture p15: CAD file, 2026-11-10]
exports/toolchain-smoke/SYNTHETIC_STEPUP_ASSEMBLY.step
50.0 x 30.0 x 11.5 mm
Pcb_d7a
J_TEST_PinHeader_1x04_P254mm_Vertical_ba3a7649bfea
