iThinkiKhan/Universal-Robotics-Remote/cad/assembly/placement-r001.FCStd

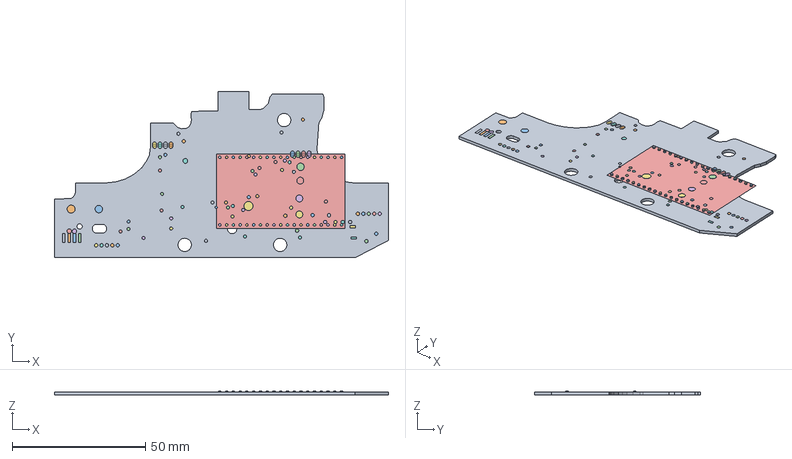
[picture p16: CAD file, 2026-11-13]
cad/assembly/placement-r001.FCStd
125.5 x 62.5 x 1.65 mm
TRACED OUTLINE (photo-rectified, +/-0.4 mm) AND HOLES — components and connectors unmodeled
TP01 GND
TP02 B+
TP03 VSS
TP04 VCC
TP05 SDA
TP06 SCL
TP07 +5V
TP08 D+
TP09 D-
TP10 R-Y
TP11 R-X
TP12 R-3
TP13 VCC
TP14 R-Y
TP15 VCC
TP16 R-X
TP17 GND
TP18 R-3
TP19 R-UP
TP20 R-RIGHT
TP21 R-LEFT
TP22 R-DOWN
TP23 U_DET
TP24 L-LEFT
TP25 L-RIGHT
TP26 L-UP
TP27 L-DOWN
TP28 VCC
TP29 (unlabeled)
TP30 L-3
TP31 L-X
TP32 L-Y
TP33 L-Y
TP34 VCC
TP35 L-X
TP36 GND
TP37 L-3
TP38 GND
TP39 R2
TP40 R1
TP41 GND
TP42 GND
TP43 L2
TP44 L1
TP45 GND
TP46 MO
TP47 MO
TP48 B-
TP49 (unlabeled)
TP50 (unlabeled)
TP51 B+
TP52 (unlabeled)
TP53 (unlabeled)
TP54 GND
TP55 RES
TP56 RESTN
TP57 RSTN
TP58 R-1
TP59 R-2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
