iThinkiKhan/Universal-Robotics-Remote/cad/enclosure/pod-r001.FCStd

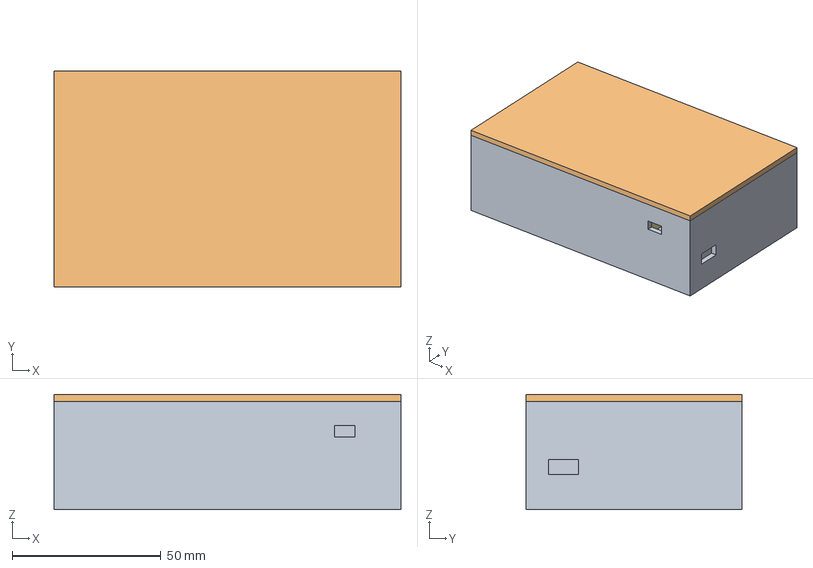
[picture p18: CAD file, 2026-11-13]
cad/enclosure/pod-r001.FCStd
116.8 x 72.8 x 38.8 mm
Tub: front and side walls with openings
Rear lid (plain plate)
DISP1 Display PCB and screen [owner-measured]
DISP1_SD Display SD slot [owner-measured in plane; ASSUMED to be on the rear face]
DISP1_HDR Display header and Dupont plugs (keep-out) [owner allowance; direction ASSUMED]
BAT2 MakerFocus 103665 battery [owner-reported nominal]
MCU1 ESP32-S3 board with its pins and wires [owner-measured outline; 20 mm height is the owner's allowance]
WRM1 ESP32-DevKitC V4 (WROOM-32U) [outline from Espressif drawing; 12 mm height ASSUMED]
CHG1 HiLetgo TP4056 USB-C charger [seller outline; 5 mm thickness ASSUMED]
REG1 XL63020 3.3 V regulator [seller outline; 5 mm thickness ASSUMED]
SW1 Slide switch (space reserved) [ASSUMED: no dimension of the owner's switch is recorded]
MIC1 Microphone with header and wires [owner-measured]
