iThinkiKhan/Universal-Robotics-Remote/cad/toolchain-smoke/SYNTHETIC_TOOLCHAIN_REVIEW.FCStd

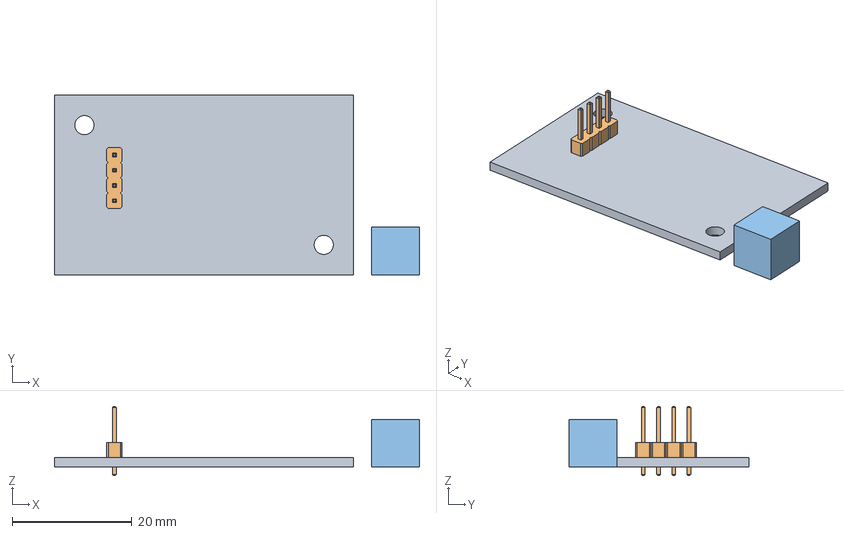
[picture p19: CAD file, 2026-11-10]
cad/toolchain-smoke/SYNTHETIC_TOOLCHAIN_REVIEW.FCStd
61.0 x 30.0 x 11.5 mm
Pcb_d7a
J_TEST_PinHeader_1x04_P254mm_Vertical_ba3a7649bfea
TEST ONLY - clear fixture
TEST ONLY - intentional collision
