iThinkiKhan/Universal-Robotics-Remote/cad/boards/gamepad-gh-wii-u002/gamepad-gh-wii-u002-survey-r002.FCStd

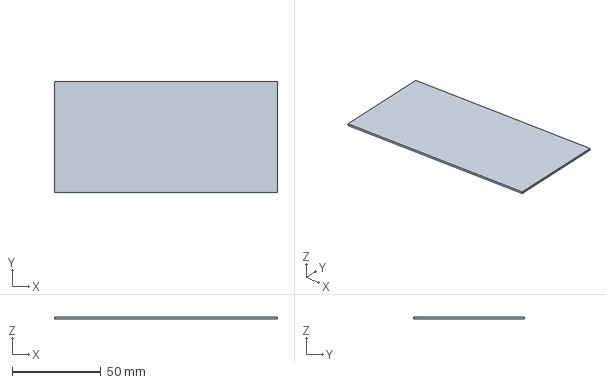
[picture p21: CAD file, 2026-11-10]
cad/boards/gamepad-gh-wii-u002/gamepad-gh-wii-u002-survey-r002.FCStd
125.5 x 62.5 x 1.15 mm
