iThinkiKhan/Universal-Robotics-Remote/(list of files, cad)

Other CAD files:
cad/harness/gamepad-harness-r001.FCStd
exports/enclosure/pod-r001-CONCEPT.step
cad/boards/gamepad-gh-wii-u002/gamepad-gh-wii-u002-survey-r005.FCStd
exports/toolchain-smoke/NATIVE_KICAD_EXPORT.step
cad/boards/gamepad-gh-wii-u002/gamepad-gh-wii-u002-survey-r003.FCStd
