iThinkiKhan/Universal-Robotics-Remote/measurements/README.md

# Measurements

`electrical.csv` contains the electrical readings and remaining initial battery/module placeholders. `boards/` owns main-PCB mechanical measurements; `photos/` holds original archives and galleries. Record instrument, power state, reference datum, date and evidence. Unknown values remain blank/null. See ../docs/MEASUREMENTS.md and ../docs/BOARD_SURVEY_WORKFLOW.md.

The main gamepad record is boards/gamepad-gh-wii-u002.json; its first four readings are described in boards/gamepad-gh-wii-u002-FIRST_READINGS.md. Earlier pending DIM01–03 envelope rows were moved out of electrical.csv so these values have one authority.

`boards/gamepad-gh-wii-u002-pads.csv` holds the traced test pads (centre, footprint, printed label and how confident that label is) and is referenced from the board record. `boards/gamepad-gh-wii-u002-features.csv` lists the connectors, pad groups, switches, contacts and separate modules still to be located, all pending until measured; hole positions go in the board JSON instead. The recording format is in ../docs/ECAD_MCAD.md.

`templates/module-readings.csv` and the three sheets in `templates/modules/` (S3 board, display module, microphone breakout) list the caliper readings needed to model those parts. Each part has its own datum (bottom-left of its PCB rectangle in a stated view); values stay blank until measured, and published sizes for these generic modules vary by vendor, so none are assumed. Tier 1 readings place a module in an assembly; tier 2 route the harness.

For MCAD, add measured board outlines, hole centers, thickness, component heights, joystick travel and cable reach here before using them in native CAD. Synthetic toolchain fixtures under cad/toolchain-smoke are not hardware measurements.

## ESP32-S3 physical measurements (2026-11-12)

`modules/esp32-s3-physical-20261112.json` records the owner's S3 N16R8 board dimensions, dual USB connector/antenna/module heights, LED and header measurements, and an explicit 20 mm assembly clearance allowance. It distinguishes reported readings from derived dimensions, approximations and still-missing coordinates. **The USB-end/antenna-end view differs from the blank S3 template sketch; reconcile the datum before placing features in CAD.** The template remains blank by design and is not the live measurement ledger.

## Touchscreen physical measurements (2026-11-12)

`modules/display-physical-20261112.json` records owner-measured PCB (50 x 86 x 1.6 mm), glass size, full thickness with SD slot, SD-slot offsets, and the 28 mm stated Dupont connector clearance. The owner confirmed **back-of-PCB view, header on the right**. Use a rear-view datum at the bottom-left: X along the 86 mm length to the header/right side, Y upward along the 50 mm width. The SD slot fits at X=26..54.5 mm and Y=31.5..48.1 mm; an earlier overhang concern came from mistaking the 50 mm Y size for the X extent. Coordinates for all four mounting-hole centers are derived from the measured edge distances in the JSON. The screen offset along PCB length and visible active area are still pending. See the JSON for raw references and confidence states.

## Circular microphone board physical measurements (2026-11-12)

`modules/mic-physical-20261112.json` records a **14 mm diameter** circular PCB with two 2 x 2 mm top/bottom notches, 1.15 mm PCB thickness, central sound port, six header pins arranged as two side-to-side centered horizontal rows (3+3 tentative), top row ~3.4 mm below top of circle, second row 7.25 mm farther down, reported row width 6.2 mm, and 26 mm total height from top of header to bottom of soldered wires. The owner explicitly corrected an initial '14in' unit typo to **14 mm**. Pin pitch, acoustic-hole diameter, the exact row-width reference, face orientation, and Z protrusions are not yet measured. Do not assume mounting holes or exact pin-center locations.

## Gamepad joystick daughterboards (2026-11-12)

`modules/joystick-daughterboards-physical-20261112.json` records the owner's provisional observation that the left/right ribbon-connected joystick boards appear identical; each irregular board measures up to 32.7 x 33.5 mm, 0.9 mm substrate. The full stack from highest bottom-side pin to joystick top measures 31 mm. Owner describes joystick near center of a roughly 30 mm circle. Three openings reported: 1.19 mm, 2.3 mm and oblong 3.7 x 2.5 mm, interpreted as hole sizes (not positions) pending photograph. Ribbon connection is 'up', joystick facing away in owner's measurement view. No exact contour, hole centers, shaft location or ribbon lengths are recorded yet. The owner provided `3102.jpg` in chat (not archived in the repository); visible from the solder side with ribbon exiting upward, showing five soldered conductors, a narrow tab, irregular perimeter and three larger openings at upper right, mid right (apparently oblong) and lower left. A near-square-on photo with a scale reference is still needed for dimensional outline tracing; do not treat a bounding rectangle as the true irregular outline.

## Shoulder-button assemblies (2026-11-12)

`modules/shoulder-button-assemblies-physical-20261112.json` documents visual observations from owner photos `3105.jpg` and `3106.jpg` (chat attachments, **not archived in GitHub**). The switch assembly has two black switch housings with circular actuator areas, linked by or adjacent to a central plastic spine, narrow green PCB solder tabs, and factory ribbon connections. Its outer width, height, depth, actuator positions, mounting features and ribbon lengths remain unmeasured; do not infer sizes from the tilted caliper in the photograph or assume the plastic is a single immovable piece.
