iThinkiKhan/Universal-Robotics-Remote/measurements/photos/gamepad-gh-wii-u002/index.html

# gamepad-gh-wii-u002 — photo archive

Sanitized reference photographs, hash-verified against the public manifest. Compressed image data is unchanged; ancillary metadata was removed. These handheld views are not to scale. Click a photograph for the full sanitized photo.

Source manifest and SHA-256 hashes

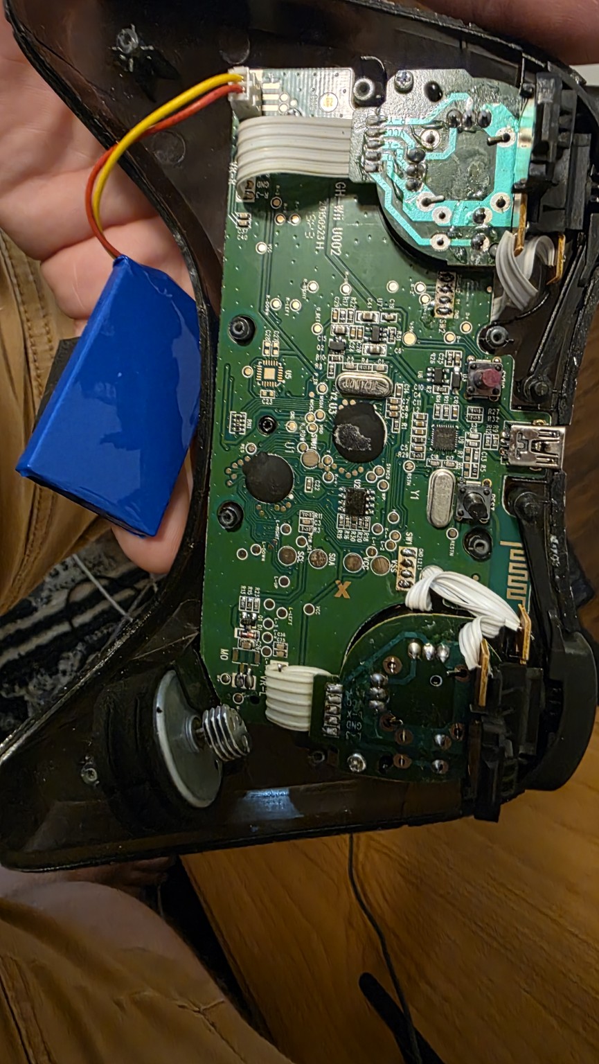
[picture p24: measurements/photos/gamepad-gh-wii-u002/originals/3079.jpg]
Original shell interior, main PCB, battery pack and joystick assemblies


## 3079.jpg

Original shell interior, main PCB, battery pack and joystick assemblies

Sanitized photo / unscaled

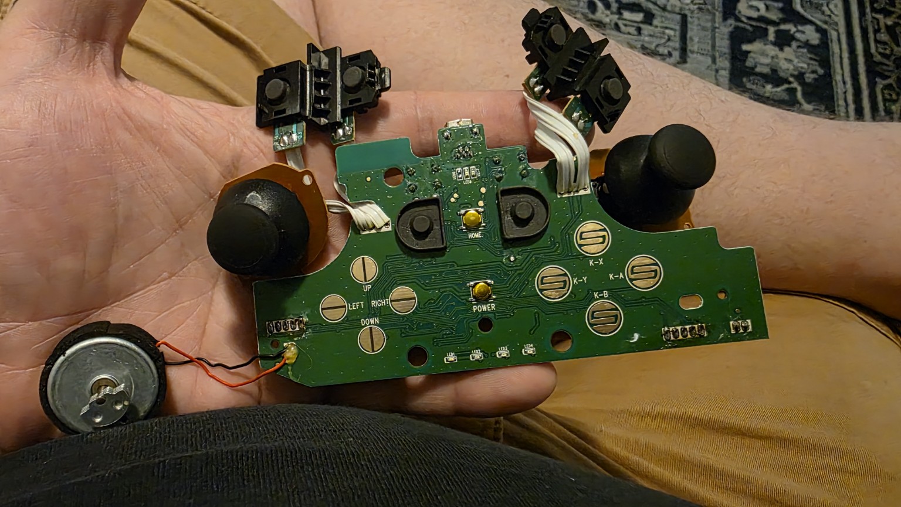
[picture p25: measurements/photos/gamepad-gh-wii-u002/originals/3080.jpg]
Button-contact side overview with joystick and shoulder modules still on ribbons


## 3080.jpg

Button-contact side overview with joystick and shoulder modules still on ribbons

Sanitized photo / unscaled

Button-contact side close overview; reference orientation for first measurements: USB at top

## 3081.jpg

Button-contact side close overview; reference orientation for first measurements: USB at top

Sanitized photo / unscaled

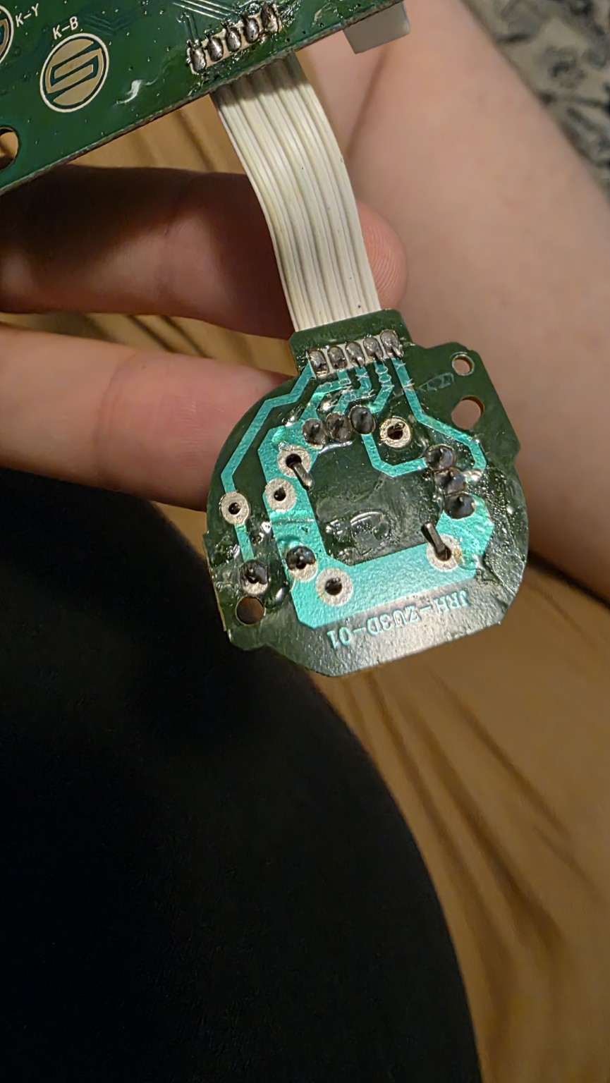
[picture p26: measurements/photos/gamepad-gh-wii-u002/originals/3082.jpg]
Joystick daughterboard solder side, ribbon and mounting-hole close-up


## 3082.jpg

Joystick daughterboard solder side, ribbon and mounting-hole close-up

Sanitized photo / unscaled

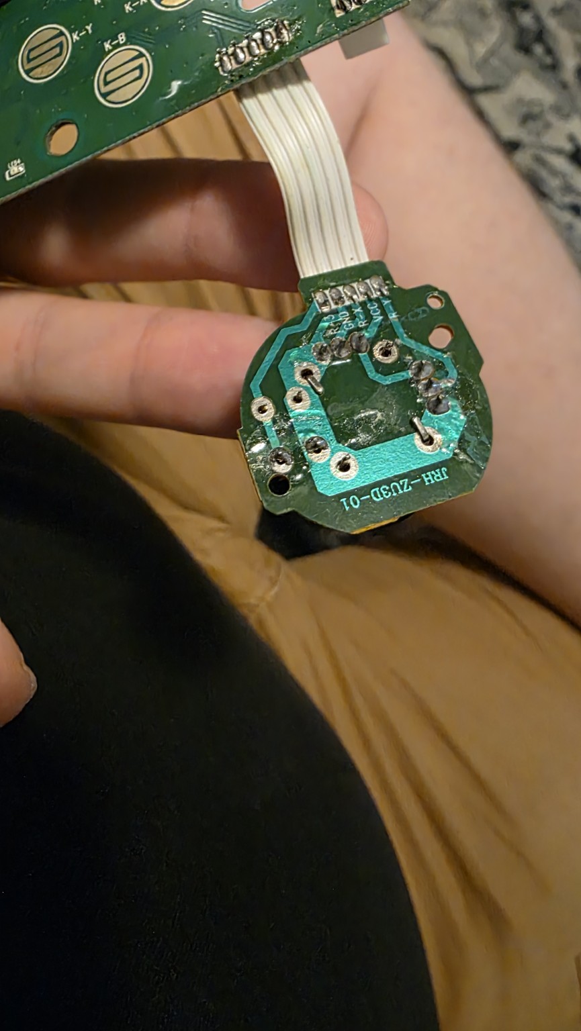
[picture p27: measurements/photos/gamepad-gh-wii-u002/originals/3083.jpg]
Joystick daughterboard alternate view with labeled ribbon connections


## 3083.jpg

Joystick daughterboard alternate view with labeled ribbon connections

Sanitized photo / unscaled

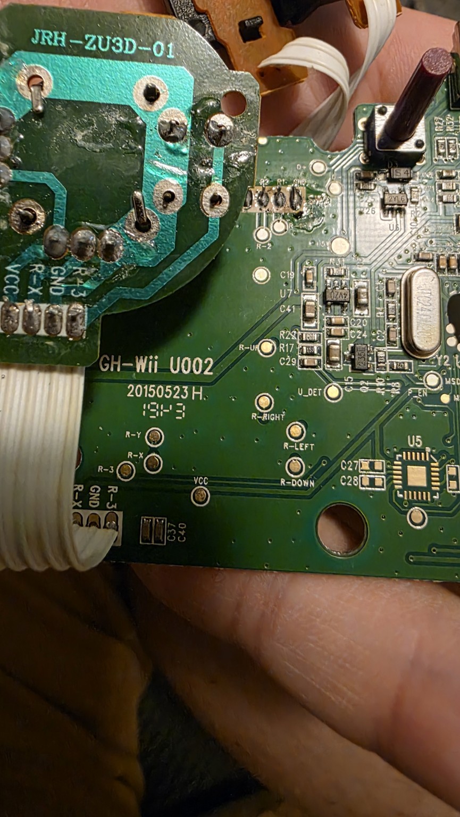
[picture p28: measurements/photos/gamepad-gh-wii-u002/originals/3084.jpg]
Main PCB identity and right-stick labeled pad region; daughterboard close-up


## 3084.jpg

Main PCB identity and right-stick labeled pad region; daughterboard close-up

Sanitized photo / unscaled

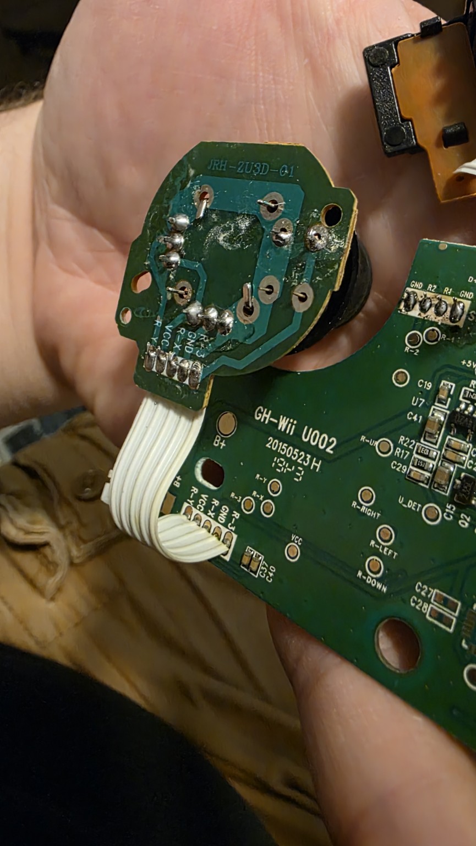
[picture p29: measurements/photos/gamepad-gh-wii-u002/originals/3085.jpg]
Joystick daughterboard shape, holes and ribbon reach reference


## 3085.jpg

Joystick daughterboard shape, holes and ribbon reach reference

Sanitized photo / unscaled

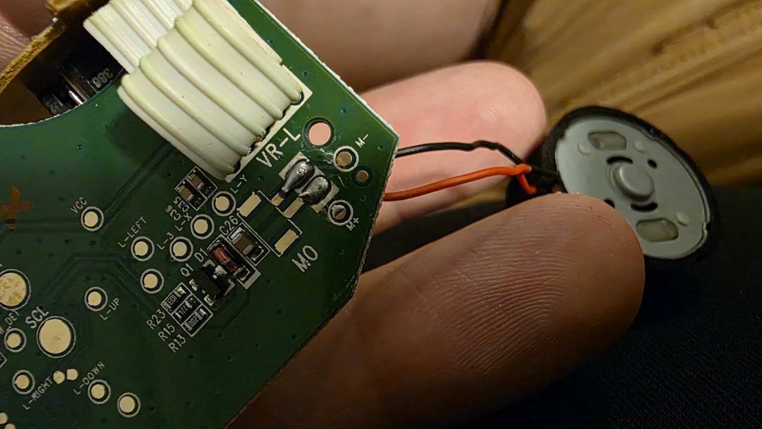
[picture p30: measurements/photos/gamepad-gh-wii-u002/originals/3086.jpg]
Main-board left-stick ribbon termination, motor wires and board-edge detail


## 3086.jpg

Main-board left-stick ribbon termination, motor wires and board-edge detail

Sanitized photo / unscaled

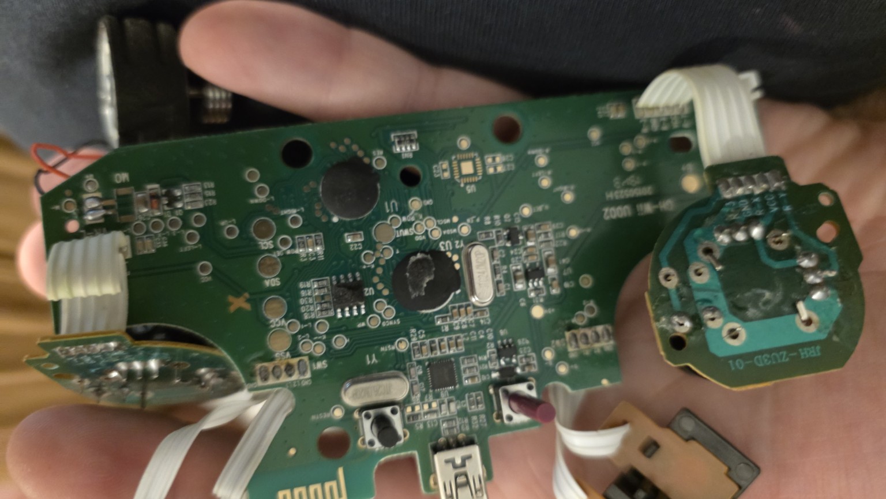
[picture p31: measurements/photos/gamepad-gh-wii-u002/originals/3087.jpg]
Main PCB rear overview, rotated; daughterboards and ribbons visible


## 3087.jpg

Main PCB rear overview, rotated; daughterboards and ribbons visible

Sanitized photo / unscaled

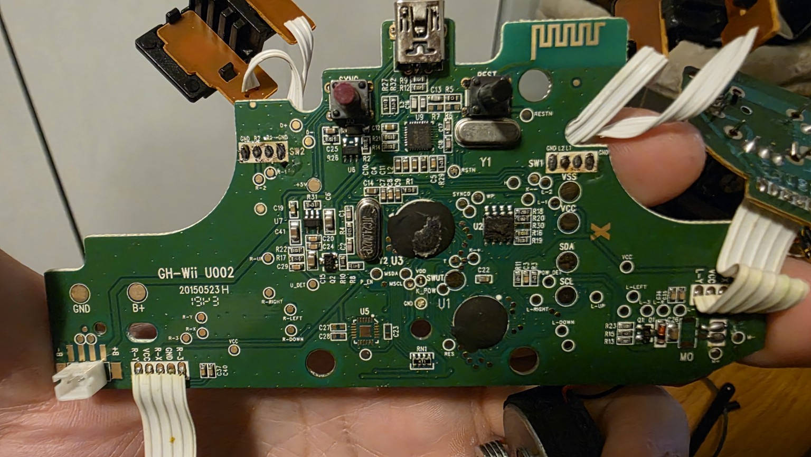
[picture p32: measurements/photos/gamepad-gh-wii-u002/originals/3089.jpg]
Sharp main-PCB rear overview showing GH-Wii U002 identity and labeled test pads


## 3089.jpg

Sharp main-PCB rear overview showing GH-Wii U002 identity and labeled test pads

Sanitized photo / unscaled
