iThinkiKhan/Universal-Robotics-Remote/measurements/templates/button-check-sheet.csv

id | signal | function | press_this | expected_pad | pad_label | x_mm | y_mm | pad_to_contact_continuity | released_v | pressed_v | other_pads_that_changed | instrument | date | state | notes
BC01 | L-3 | Left stick click | left stick click | TP30 | L-3 | 105.60 | 13.40 |  | 3.0 | 0 |  | digital multimeter model unknown | 2026-11-10 | owner-reported | Approximate readings from measurements/electrical.csv BTN05 and BTN06. Which L-3 pad was probed is not recorded.
BC02 | R-3 | Right stick click | right stick click | TP12 | R-3 | 24.85 | 9.85 |  | 3.0 | 0 |  | digital multimeter model unknown | 2026-11-10 | owner-reported | Approximate readings from measurements/electrical.csv BTN07 and BTN08. Which R-3 pad was probed is not recorded.
BC03 | R-UP | Face button X (top) | K-X carbon contact | TP19 | R-UP | 40.45 | 23.95 |  |  |  |  |  |  | pending | Expected from the buttons already measured: about 3 V released, 0 V pressed. Press the button and confirm this pad drops; note any other pad that changes (a matrix would show here).
BC04 | R-RIGHT | Face button A (right) | K-A carbon contact | TP20 | R-RIGHT | 40.25 | 17.75 |  |  |  |  |  |  | pending | Expected from the buttons already measured: about 3 V released, 0 V pressed. Press the button and confirm this pad drops; note any other pad that changes (a matrix would show here).
BC05 | R-DOWN | Face button B (bottom) | K-B carbon contact | TP22 | R-DOWN | 43.85 | 10.95 |  |  |  |  |  |  | pending | Expected from the buttons already measured: about 3 V released, 0 V pressed. Press the button and confirm this pad drops; note any other pad that changes (a matrix would show here).
BC06 | R-LEFT | Face button Y (left) | K-Y carbon contact | TP21 | R-LEFT | 43.85 | 14.75 |  |  |  |  |  |  | pending | Expected from the buttons already measured: about 3 V released, 0 V pressed. Press the button and confirm this pad drops; note any other pad that changes (a matrix would show here).
BC07 | R-1 | Right shoulder R | right shoulder board, R switch | TP58 | R-1 | 41.65 | 38.65 |  |  |  |  |  |  | pending | Expected from the buttons already measured: about 3 V released, 0 V pressed. Press the button and confirm this pad drops; note any other pad that changes (a matrix would show here).
BC08 | R-2 | Right trigger ZR | right shoulder board, ZR switch | TP59 | R-2 | 39.65 | 37.75 |  |  |  |  |  |  | pending | Expected from the buttons already measured: about 3 V released, 0 V pressed. Press the button and confirm this pad drops; note any other pad that changes (a matrix would show here).
BC09 | L-UP | D-pad up | D-pad UP contact | TP26 | L-UP | 97.00 | 16.00 |  |  |  |  |  |  | pending | Expected from the buttons already measured: about 3 V released, 0 V pressed. Press the button and confirm this pad drops; note any other pad that changes (a matrix would show here).
BC10 | L-RIGHT | D-pad right | D-pad RIGHT contact | TP25 | L-RIGHT | 86.75 | 15.75 |  |  |  |  |  |  | pending | Expected from the buttons already measured: about 3 V released, 0 V pressed. Press the button and confirm this pad drops; note any other pad that changes (a matrix would show here).
BC11 | L-DOWN | D-pad down | D-pad DOWN contact | TP27 | L-DOWN | 91.15 | 10.15 |  |  |  |  |  |  | pending | Expected from the buttons already measured: about 3 V released, 0 V pressed. Press the button and confirm this pad drops; note any other pad that changes (a matrix would show here).
BC12 | L-LEFT | D-pad left | D-pad LEFT contact | TP24 | L-LEFT | 103.15 | 15.95 |  |  |  |  |  |  | pending | Expected from the buttons already measured: about 3 V released, 0 V pressed. Press the button and confirm this pad drops; note any other pad that changes (a matrix would show here).
BC13 | L-1 | Left shoulder L | left shoulder board, L switch | TP72 | L-1 | 89.95 | 32.25 |  |  |  |  |  |  | pending | Expected from the buttons already measured: about 3 V released, 0 V pressed. Press the button and confirm this pad drops; note any other pad that changes (a matrix would show here).
BC14 | L-2 | Left trigger ZL | left shoulder board, ZL switch | TP71 | L-2 | 88.35 | 35.85 |  | 3.0 | 0 |  | digital multimeter model unknown | 2026-11-10 | owner-reported | Approximate readings from measurements/electrical.csv BTN10 and BTN11 (left shoulder held). The owner named the pad L-2, this pad's spelling. Which of the two left shoulder switches was held is not recorded.
BC15 | K-+ | Plus / Start | rubber-dome button right of HOME (front view) | TP73 | K-+ | 76.20 | 23.10 |  |  |  |  |  |  | pending | Expected from the buttons already measured: about 3 V released, 0 V pressed. Press the button and confirm this pad drops; note any other pad that changes (a matrix would show here).
BC16 | K-- | Minus / Select | rubber-dome button left of HOME (front view) | TP69 | K-- | 86.55 | 36.45 |  |  |  |  |  |  | pending | Candidate pad; the one that follows the button is K--. Expected from the buttons already measured: about 3 V released, 0 V pressed. Press the button and confirm this pad drops; note any other pad that changes (a matrix would show here).
BC17 | K-- | Minus / Select | rubber-dome button left of HOME (front view) | TP70 |  | 85.50 | 33.00 |  |  |  |  |  |  | pending | Candidate pad; the one that follows the button is K--. Expected from the buttons already measured: about 3 V released, 0 V pressed. Press the button and confirm this pad drops; note any other pad that changes (a matrix would show here).
BC18 | H | HOME | HOME tact switch | TP68 | H | 83.05 | 35.95 |  |  |  |  |  |  | pending | Expected from the buttons already measured: about 3 V released, 0 V pressed. Press the button and confirm this pad drops; note any other pad that changes (a matrix would show here).
