iThinkiKhan/Universal-Robotics-Remote/(commit log)

2026-11-10 Initial public engineering sources
    [NATIVE_KICAD_EXPORT.step, SYNTHETIC_STEPUP_ASSEMBLY.step, SYNTHETIC_TOOLCHAIN_REVIEW.FCStd, SYNTHETIC_TOOLCHAIN_TEST.kicad_pcb, electrical.csv, gamepad-gh-wii-u002-survey-r002.FCStd]
2026-11-10 Record owner-reported gamepad electrical measurements (#3)
    Record rail, joystick and button readings with their test conditions and provenance. Preserve uncertainty and unresolved power-state and bus questions; no runtime or wiring changes.
    [electrical.csv]
2026-11-10 Capture limited no-traffic logic analyzer finding and first ADC test handoff
2026-11-10 Record DIY analyzer negative observation with capture limitations
    [electrical.csv]
2026-11-10 Update electrical status after logic analyzer probe and define first ADC milestone
2026-11-10 Prepare supervised single-axis bench test and staged interface model
    [lx-observer-session.csv]
2026-11-10 Define integrated KiCad harness and FreeCAD assembly as project end state
2026-11-10 Record first visible L-X response from direct bench probe
2026-11-10 Add measured outline and hole support to the board survey builder
    The survey builder could only produce a W/H/T bounding envelope. It now
    builds a native board body from a measured outline (straight segments and
    arcs) with round and slot holes, and cross-checks the saved result.
    - survey_geometry.py: pure-Python validator. Builds only from entries marked
    measured, requires a named datum, and rejects an outline that disagrees
    with measured W/H, self-crossing outlines, and holes that leave the board
    or overlap.
    - build_board_survey.py: builds MeasuredBoardBody and verifies volume,
    thickness and hole count after reopening. Records without an outline
    still build the unchanged envelope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
    [gamepad-gh-wii-u002-features.csv]
2026-11-10 Record datum, hole readings and a traced outline; build survey r003
    Revision 3 of the GH-Wii U002 survey now has a datum, caliper hole readings
    and a board outline, so the native model is the real board shape with its
    holes instead of a W x H rectangle.
    Measurements
    - Datum: bottom-left of the bounding rectangle in the rear (component-side)
    view, USB at top, battery-connector end. Instrument recorded as the
    AOCORIC 09-15473 caliper.
    - Holes B, C, D, E, F from near-wall caliper readings; hole A has a caliper Y
    and a photo-derived X (+/-0.4 mm). Hole A diameter updated to 5 mm per the
    owner, superseding 4.83 mm.
    - Outline recorded as a "traced" contour, not a caliper measurement: read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
    [gamepad-gh-wii-u002-survey-r003.FCStd]
2026-11-10 Update public status, README and history for the board model r003
    STATUS.md and README.md still said the contour and hole positions were
    unmeasured and that r002 (an envelope only) was the current model. Describe
    r003: the datum, the hole readings, the photo-traced contour with its stated
    uncertainty and bridged stretches, and what is still unmodeled. Replace the
    stale "agree a datum, measure the contour" next steps with the remaining
    spot-checks and connector/pad measurements, and add a history entry.
2026-11-10 Add 67 traced test pads to the board survey and build r004
    The survey now records where the test pads are, in the datum frame, so
    harness planning can start from real positions instead of photo labels.
    Pads
    - measurements/boards/gamepad-gh-wii-u002-pads.csv: 67 pads with centre,
    footprint (round, rect or oval), printed label and a label-confidence flag.
    Read off the rectified rear-view photograph and snapped to detected circle
    centres where possible; every row is "traced" with a method and +/-0.4 mm
    uncertainty, never passed off as a caliper reading.
    - Covers the large power and bus pads, the right- and left-stick test and
    direction pads, both stick ribbon rows, the SW1 and SW2 sh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
    [gamepad-gh-wii-u002-features.csv, gamepad-gh-wii-u002-pads.csv, gamepad-gh-wii-u002-survey-r004.FCStd]
2026-11-10 Add a harness package: connection list, ordering list and plan
    Assemble what is needed to build a high-quality harness for the important
    connections, tied to the records that already exist instead of a new pin table.
    - electronics/harness-sources-proposed.csv: every important connection with
    the pad IDs it lands on (from the pad table), the J1 registry pin numbers,
    a status and the gate behind it. Three connections are plan-ready (right
    stick X, Y and click); ten are blocked, three held (gamepad power, SDA and
    SCL, the spare) and six original ribbon/lead assemblies are recorded as
    retained. Left-stick rows stay blocked until the printed labels of four pads
    are read; ambiguous ro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
    [harness-continuity-sheet.csv, harness-procurement-proposed.csv, harness-sources-proposed.csv]
2026-11-11 Add measurement sheets for the S3, display and microphone modules
    The S3 board, display module and microphone breakout have no recorded
    dimensions, and published sizes for these generic parts vary by vendor,
    so no model is built from assumed numbers. Add a blank reading template
    (68 rows, tiered by need) and one guide sheet per module showing the
    datum, viewing side and where each reading is taken. A test checks that
    every row appears on its sheet and that nothing is filled in before it
    is measured. Update status, history, the measurements README and the
    harness plan's M5 item.
    [module-readings.csv]
2026-11-11 Complete the pad table (83 pads, survey r005) and propose the button harness
    - Add 16 pads read off the rectified rear-view photo and zoomed crops of
    photos 3089 and 3086: the round button test pads H, K-+, L-1, L-2 and a
    K-- candidate pair, the T, SYNCO, WP and POW_DET test points, four
    unlabeled pads and the round M+ and M- motor pads (about +/-1 mm, hidden
    by the ribbon in the rectified photo).
    - Read three of the round pads beside the left-stick ribbon as L-3, L-X and
    L-Y. Revise the P_EN, MSDA and MSCL attributions beside U3 (still low
    confidence). Every row stays traced, never a caliper reading.
    - Build and render FreeCAD r005 (84 solids: board plus 83 pads). r004 is k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
    [button-check-sheet.csv, gamepad-gh-wii-u002-pads.csv, gamepad-gh-wii-u002-survey-r005.FCStd, harness-continuity-sheet.csv, harness-sources-proposed.csv]
2026-11-11 Fold the recorded button readings into the harness package
    The owner-reported readings in measurements/electrical.csv already establish
    the voltage levels (about 3 V logic, active-low buttons), so the button check
    no longer asks for them again.
    - Button check sheet: L-3, R-3 and L-2 are prefilled from ledger entries
    BTN05 to BTN08, BTN10 and BTN11; the other 13 buttons need only a
    press-and-confirm at their expected pad.
    - Connection list: L-3 and R-3 no longer wait on the button check; L-2 waits
    only on the interface decision.
    - Harness plan and status reworded: voltage levels are on record, pad
    identity is what remains.
    - New test: prefilled rows may only restate readings found in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
    [button-check-sheet.csv, harness-sources-proposed.csv]
2026-11-11 Correct the harness plan's S3 pin claim and note the owner's JST stock
    The plan said the S3 lacked free pins for the button lines. The owner reports
    many exposed, unused S3 pins with only the display, touch and microphone wired,
    but did not record which. State what is known: occupied GPIOs, the registry's
    unallocated set, and that the usable header positions are still to be listed, so
    the I2C expander option (D2) is neither adopted nor ruled out.
    Also record that the owner has JST connectors in two sizes on hand, with series,
    pitch and position counts unconfirmed against the GH 8/10-position proposal (D1).
2026-11-11 Record the owner's S3 header read-out and free-pin rule in the harness plan
    The owner read the S3 header on 2026-11-11: RST, 5V, GND and 22 GPIOs not used
    by the screen or microphone. Those split into 11 free GPIOs, 8 taken by S3
    operation (straps, native USB, UART0 bridge) and 3 taken by the octal PSRAM.
    State the owner's free-pin rule, that the 11 free pins are confirmed exposed,
    and that 7 remain after the four axes against 17 button and click lines, so the
    I2C expander proposal (D2) stands and the choice of direct lines stays open.
2026-11-11 Record the WROOM-32U button-processor proposal and add measurement M8
    The owner proposes an ESP32-WROOM-32U that reads the 16 gamepad buttons (the 12
    on the front including HOME and POWER, plus four shoulders) and sends their
    state to the S3 over UART, as an alternative to the I2C expander in D2. The
    sticks and their clicks stay on the S3, so J1 is unchanged. The connection list
    has 15 of the 16 buttons; the 16th, POWER, is the original controller's power
    key whose voltage is unmeasured. Backfeed is recorded as not a design driver
    per the owner.
    Add M8: DC voltage and direction of the original controller's K_POW, SYNCO,
    RSTN, RES, POW_DET and P_EN pads before any of them is used, since the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
2026-11-11 Add protection to the harness plan only when a need is shown
    The owner directs that backfeed isolation and other protection circuitry are
    added only when a real need appears, not because they are advisable, since this
    is a homebrew project. Reword the D2 interface-architecture entry and build
    principle 6, which had required a protective interface before a permanent
    harness, and the WROOM proposal sentence that said backfeed was not a design
    driver. The project plan's older wording is the owner's text and is left for
    the owner to reconcile. Measuring unknown voltages before connecting them to a
    3.3 V pin (M8) is unchanged.
2026-11-11 Split the harness into seven JST XH connectors and add the button processor
    Owner decisions of 2026-11-11, applied to the registries and the records.
    Connectors and architecture
    - JST XH from the owner's stock (2.5 mm pitch, 6 positions at most) replaces
    the 8- and 10-position proposal. Seven signal connectors: J1L and J1R
    (sticks, to the S3), J2F, J2R, J2D, J2L and J2C (buttons, to an
    ESP32-DevKitC V4 with a WROOM-32U that reports them to the S3 over a UART).
    - harnesses.json is schema 2 (destination per connector, button list).
    signals.json drops the I2C expander pair, adds the button link on S3 GPIO18,
    proposes L-3 on GPIO21 and R-3 on GPIO1, and gains a proposed input map for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
    [electrical.csv, gamepad-gh-wii-u002-pads.csv, harness-continuity-sheet.csv, harness-procurement-proposed.csv, harness-sources-proposed.csv, netlist-proposed.csv]
2026-11-11 Render the harness drawings and start the 3D harness model
    Drawings
    - Eight WireViz drawings rendered with WireViz 0.4.1: one per connector and
    an overview of all seven with the button link. Each wire shows its test pad,
    wire ID, housing position and far-end pin. A manifest records source and
    output hashes.
    - The tap map is redrawn for the seven connectors and the two shared ground
    pads.
    3D harness model r001
    - scripts/cad/build_harness_model.py copies the surveyed board (r005) and puts
    a marker on each of the 24 pads the 28 wires land on, with the wire IDs as
    properties; render_harness_model.py produces the review views. Built and
    rendered with FreeCAD 1.0.0 and checked after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
    [gamepad-harness-r001.FCStd]
2026-11-12 Check the pin mapping against Espressif's documents and add the placement study
    Record the DevKitC V4 header tables, module facts and board geometry with their
    sources, validate the proposed WROOM-32U pins against them, add a netlist-level
    test class, and build an XY placement study of the DevKitC against the gamepad
    board (FreeCAD model, top view, tested pose maths). Record the controller battery
    (MakerFocus 103665, 65 x 36 x 10 mm nominal) and the DevKitC in the component
    list and mark the I2C expander superseded.
    Heights, housings, routing and the S3, display, microphone and battery
    placement are not modelled; lengths are straight-line lower bounds.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
    [placement-r001.FCStd]
2026-11-12 Record owner-measured ESP32-S3 geometry with explicit datum and uncertainty
2026-11-12 Index S3 dimensional survey for CAD modelers
2026-11-12 Confirm S3 has no mounting holes and display/mic wiring is soldered
2026-11-12 Record measured display PCB, glass, SD slot and Dupont clearance with unresolved geometry flagged
2026-11-12 Index measured display geometry and flag SD slot placement for CAD
2026-11-12 Record display mounting-hole positions and header geometry with edge-reference caveats
2026-11-12 Fix touchscreen rear-view datum and SD slot coordinates; derive four mounting hole centers
2026-11-12 Document confirmed rear-view display coordinate system and resolved SD slot geometry
2026-11-12 Confirm non-header screen margin and resolve mirrored front/rear CAD placement
2026-11-12 Record 14-pin display header count
2026-11-12 Record owner-measured 14 mm circular mic PCB, notches, pin-row layout and stack clearance
2026-11-12 Index mic PCB measurements with corrected 14 mm diameter and unresolved header details
2026-11-12 Record provisional paired joystick PCB envelopes and hole sizes pending photo
2026-11-12 Annotate joystick rear photo topology, five-pad ribbon and candidate mounting hole positions
2026-11-12 Identify upper-right joystick mounting hole as 1.19 mm
2026-11-12 Place the S3 against the gamepad board and park the other modules (placement r002)
    Add the S3 from the owner's 2026-11-12 readings (header order assumed from
    Espressif's DevKitC-1), its stick wires and the UART link, and the display,
    battery and microphone as parked reference bodies. With the DevKitC at its r001
    pose no single-layer S3 pose fits; the stacked optimum is recorded. XY study,
    lengths are lower bounds.
    [placement-r002.FCStd]
2026-11-12 Document shoulder-switch photo topology and pending physical dimensions
2026-11-12 Index visual observations and missing dimensions for shoulder switch assemblies
2026-11-12 Record shoulder-switch assembly envelope 37 x 29 x 15 mm
2026-11-12 Record 18.5 mm shoulder actuator spacing; flag 2 mm height reference as ambiguous
2026-11-12 Clarify shoulder button stands about 2 mm proud of its plastic housing
2026-11-12 Locate both shoulder actuator centers using measured 9.2 mm left offset
2026-11-12 Record 7.5 mm top-edge offset for shoulder actuator center
2026-11-12 Flag failing shoulder ribbons and remove ribbon length as CAD design requirement
2026-11-12 Flag deteriorating shoulder ribbons as harness design blocker, not a cable-length measurement
2026-11-12 Confirm left and right shoulder switch assemblies are mirrored with matching external dimensions
2026-11-12 Record shoulder switch assemblies held by original housing wings
2026-11-12 Record switch-mounted retaining wings and measured left ear and right elevated-wing references
2026-11-12 Clarify right shoulder retaining wing spans full black plastic housing length
2026-11-13 Capture shoulder right housing 15 mm and black plastic overall rise 23 mm
2026-11-13 Confirm 23 mm shoulder plastic height excludes PCB tabs
2026-11-13 Record the approved single-pack controller power design
    [electrical.csv, power-verification-20261113.csv]
2026-11-13 Start the enclosure: add-on pod concept r001 and its reading sheet
    Owner chose to keep the gamepad in its original shell and house the display,
    both ESP boards and the power parts in a printed pod. pod-r001 is a space
    claim only (several heights assumed, no mount), not a printable part.
    [pod-r001-CONCEPT.step, pod-r001.FCStd, pod-readings.csv]
